apku04/stm32_saturn/.squad/log/2026-04-23T14:50:20Z-i2c2-ina219-beacon.md

# Session Log: I2C2 / INA219 Beacon Implementation

**Timestamp:** 2026-04-23T14:50:20Z  
**Session:** i2c2-ina219-beacon  
**Team Root:** /home/pi/work/stm32

---

## Executive Summary

Squad successfully resolved a critical I2C2/INA219 pin mismatch and restored LED functionality 
through coordinated PCB verification, code review, and surgical correction.

### Timeline
- **2025-07-14:** Kotov identified PCB truth (PB8/9, AF6, addr 0x40)
- **2025-07-17:** Yarrick implemented I2C2+INA219 (wrong pins: PB13/14)
- **2025-07-17:** Eisenhorn reviewed & rejected (issued lock-out, prescribed fix)
- **2025-07-18:** Cawl applied fix (PB8/9 AF6, restored LEDs)
- **2026-04-23:** Brostin testing (in progress)

### Outcome
- **Firmware state:** Commit 910cb9c (clean build)
- **INA219:** Correct pins (PB8/9) + correct AF (6) + correct peripheral (I2C2)
- **LEDs:** Restored on PB13/PB14
- **Beacon:** V2 format (7 bytes: shunt/bus/bat/chg)
- **Monitor:** Parsing updated for V2 + legacy fallback

---

## Root Cause

**The bug was never about which I2C peripheral (I2C2 is correct).**  
**The bug was not even about pins (PB8/PB9 is correct).**  

**The bug was: using AF4 instead of AF6**

On STM32U073CBT6, PB8/PB9 can be routed to either:
- AF4 → I2C1 peripheral (original code, wrong)
- AF6 → I2C2 peripheral (correct, 1-line fix)

Previous "fixes" (moving to PB6/7, then PB13/14) were chasing symptoms instead of 
addressing the root cause. Eisenhorn's independent PCB verification prevented a 
third wrong migration.

---

## Agent Contributions

### Kotov (PCB Expert)
- Decoded EasyEDA SQLite DB (stm32_lora.eprj)
- Traced physical net topology: INA219 on PB8/9 (not PB6/7 or PB13/14)
- Verified AF mapping: PB8/9 support AF4→I2C1 or AF6→I2C2
- **Status:** Correct on all technical points

### Yarrick (STM32 Firmware)
- Implemented I2C2 driver with base-address macros (scalable design)
- Added `ina219_read_shunt_mv()` for full current measurement
- Extended beacon to 7 bytes (shunt/bus/bat/chg)
- Updated monitor with V2 beacon parsing
- **Issue:** Selected wrong pins (PB13/14 = LEDs, not INA219)
- **Lesson:** Always verify pin assignments against PCB schematic before committing
- **Status:** Locked out from I2C/pin changes; code quality otherwise sound

### Eisenhorn (Hallucination Detective)
- Independently verified PCB topology (coordinate tracing)
- Identified root cause: AF4 vs AF6 (not pins themselves)
- Performed register/protocol audit (all correct in Yarrick's code)
- Issued REJECTED verdict with lock-out and prescribed fix
- **Status:** Prevented third wrong pin migration

### Cawl (Architect)
- Executed 3 surgical edits (hw_pins.h, i2c.c, main.c)
- Restored PB8/PB9 (AF6) for I2C2/INA219
- Restored LED functionality (PB13/PB14)
- Clean build, no regressions
- **Commit:** 910cb9c
- **Status:** Fix applied; testing in progress

### Brostin (Integration Specialist)
- Wrote comprehensive test plan (ina219_beacon_test_plan.md)
- Running single + target-to-target tests
- **Status:** In progress
- Previous findings: I2C1/I2C2 mismatch, lack of shunt register, no bus recovery

---

## Technical Details

### Pin Assignment
| Component | Pins | AF | Peripheral | Status |
|---|---|----|---  |---|
| INA219 | PB8/9  | 6  | I2C2 | ✅ Correct |
| I2C conn  | PB6/7  | 4  | I2C1 | ✅ External header |
| LEDs | PB13/14| —  | GPIO | ✅ Restored |

### Firmware Files Modified (Cawl's fix)
1. `firmware/src/board/hw_pins.h` — Pin defines & comments
2. `firmware/src/driver/i2c.c` — AF6 setting in i2c2_init()
3. `firmware/app/lora/main.c` — LED function restoration

### Beacon Payload (V2)
```
[0:1]   shunt_mv (int16, big-endian)  — INA219 reg 0x01
[2:3]   bus_mv (uint16, big-endian)   — INA219 reg 0x02 >> 3
[4:5]   bat_mv (uint16, LE)           — ADC result × 6600/4096
[6]     chg (uint8)                   — charge status
```

### Monitor Parser
- BEACON_PATTERN_V2: `[BEACON] shunt=... bus=... bat=... chg=... entries=...`
- Legacy fallback: `[BEACON] bat=... sol=... chg=...` (5-byte format)

---

## Decision Log

### Decision 1: INA219 PCB Ground Truth (Kotov)
- **Date:** 2025-07-14
- **Status:** Finding (requires firmware action)
- **Key facts:** PB8/9 (INA219), PB6/7 (I2C header), addr 0x40, AF6 for I2C2

### Decision 2: I2C2 Migration (Yarrick)
- **Date:** 2025-07-17
- **Status:** Implemented but **REJECTED**
- **Commit:** 1bba9d5
- **Issue:** Wrong pins (PB13/14 = LEDs, not wired to INA219)

### Decision 3: I2C Pin Conflict Verdict (Eisenhorn)
- **Date:** 2025-07-17
- **Status:** REJECTED Yarrick, issued lock-out
- **Prescribed fix:** PB8/9 (AF6), restore LEDs
- **Key lesson:** AF4 vs AF6 was the 1-line fix all along

### Decision 4: I2C2 Pin Correction (Cawl)
- **Date:** 2025-07-18
- **Status:** Applied (commit 910cb9c)
- **Scope:** 3 surgical edits, build clean

---

## Cross-Agent Learnings

### For Yarrick
- Always verify pin assignments against Kotov's PCB database before committing
- Prefer AF changes (1-line fix) over pin migrations (PCB verification required)
- **Lock-out:** I2C and pin changes; others own I2C/INA219 domain until further notice

### For Ravenor
- INA219 now on I2C2 (not I2C1)
- Beacon format is now 7 bytes (V2), legacy 5-byte format still supported
- PCB has two I2C buses: I2C1 on PB6/7 (external), I2C2 on PB8/9 (INA219)
- **Shared knowledge:** Kotov's PCB topology findings (pin mapping, AF values)

### For Future Squad
1. **PCB verification before pin changes:** Always consult Kotov's EasyEDA database
2. **AF vs pins:** AF changes (register-only) are cheaper than pin migrations (requires PCB verification)
3. **Lock-outs protect domain:** When an agent breaks a subsystem, lock-out prevents repeat errors
4. **Code quality ≠ correctness:** Yarrick's code was well-structured but used wrong pins — PCB verification is orthogonal to code review

---

## Testing Status

**Pending:** Brostin's test results (single + target-to-target)

**Test plan:** `firmware/app/lora/test/ina219_beacon_test_plan.md`

### Known Constraints (Brostin's baseline findings)
- No I2C bus recovery (stuck SDA/SCL requires power cycle)
- INA219 failure returns 0 (no crash), should add debug `get ina219` command
- Beacon timeout: ~6ms (100k iterations)

---

## Files Staged for Commit

```
.squad/orchestration-log/
  2026-04-23T14:50:20Z-kotov-i2c2-pins.md
  2026-04-23T14:50:20Z-yarrick-i2c2-ina219.md
  2026-04-23T14:50:20Z-eisenhorn-review-i2c2.md
  2026-04-23T14:50:20Z-cawl-pin-fix.md
  2026-04-23T14:50:20Z-brostin-run-tests.md

.squad/log/
  2026-04-23T14:50:20Z-i2c2-ina219-beacon.md (this file)

.squad/decisions.md
  (merged from inbox, deduplicated)
```
