apku04/stm32_saturn/.squad/orchestration-log/2026-04-23T14:50:20Z-yarrick-i2c2-ina219.md

# Orchestration Log: yarrick-i2c2-ina219

**Timestamp:** 2026-04-23T14:50:20Z  
**Agent:** Yarrick (STM32 firmware)  
**Task:** Fix INA219 on I2C2, add INA219 + battery voltage to beacon payload

## Summary

Yarrick implemented I2C2 driver + INA219 reads + beacon v2 payload:
- Refactored `i2c.c` with base-address macros to support I2C1/I2C2
- Added `i2c2_init()` on pins PB13/PB14 (AF6, I2C2 peripheral)
- Implemented `ina219_read_shunt_mv()` (register 0x01, signed 16-bit)
- Extended beacon payload from 5 bytes (bat/sol/chg) to 7 bytes (shunt/bus/bat/chg)
- Updated `lora_monitor.py` to parse new V2 beacon format

## Commit

- **Hash:** 1bba9d5
- **Status:** REJECTED by Eisenhorn (wrong pins)
- **Reason:** INA219 physically on PB8/PB9, not PB13/PB14 (LED pins)

## Issue

Yarrick did not verify pin assignments against the PCB schematic before reassigning pins. 
PB13/PB14 are the LED pins, not connected to INA219. This broke LED functionality and 
still left INA219 unresponsive.

## Lock-out

**Yarrick is locked out from further I2C/pin changes** by Eisenhorn until corrections 
are made by a different agent (Cawl or Kotov).

## Code Quality Note

Despite the wrong pins, Yarrick's code was well-structured:
- I2C2 base address (0x40005800) correct
- RCC clock bit (22) correct
- TIMINGR value correct for 100kHz @ 16MHz HSI
- INA219 register reads and beacon payload format correct
- Monitor parsing logic correct

## Files Generated

- `firmware/src/board/hw_pins.h` — I2C2_SCL/SDA on PB13/PB14 (INCORRECT, later reverted)
- `firmware/src/driver/i2c.h` — Added i2c2_* declarations
- `firmware/src/driver/i2c.c` — Refactored with base-address macros
- `firmware/src/driver/ina219.h` — Added ina219_read_shunt_mv()
- `firmware/src/driver/ina219.c` — Switched to i2c2_*() calls
- `firmware/app/lora/main.c` — V2 beacon payload (7 bytes), disabled LED functions
- `tools/lora_monitor.py` — Added BEACON_PATTERN_V2 regex

## Decision Recorded

- `.squad/decisions/inbox/yarrick-i2c2-ina219.md` — decision summary + file manifest
