apku04/stm32_saturn/docs/hardware/SCH_Schematic1_1-P1_2026-04-24.png

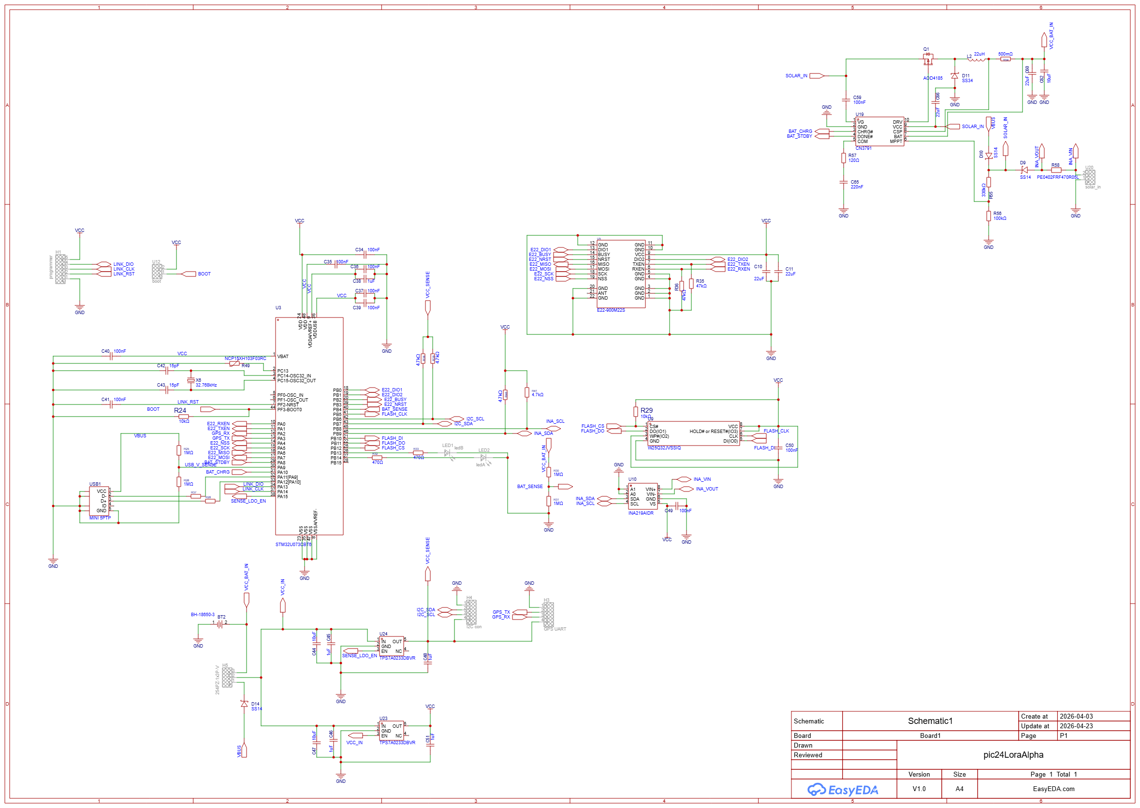
docs/hardware/SCH_Schematic1_1-P1_2026-04-24.png
