apku04/stm32_saturn/.squad/orchestration-log/2026-04-23T14:50:20Z-cawl-pin-fix.md

# Orchestration Log: cawl-pin-fix

**Timestamp:** 2026-04-23T14:50:20Z  
**Agent:** Cawl (Architect)  
**Task:** Apply surgical fix to correct I2C2 pins and restore LED functionality

## Summary

Cawl executed Eisenhorn's prescribed fix with three surgical edits:

### Changes Applied

**1. `firmware/src/board/hw_pins.h`**
- Removed `I2C2_SCL/SDA` defines on PB13/PB14
- Restored `LED1_PIN=13` and `LED2_PIN=14`
- Updated comment: "I2C2 (INA219 on PB8/PB9, AF6)"

**2. `firmware/src/driver/i2c.c`**
- Modified `i2c2_init()` to use `INA_SCL_PIN` (8) and `INA_SDA_PIN` (9)
- Set AF to 6 (not 4) in AFRH register: `afrh = 0x66` (AF6 for PB8 and PB9)
- Kept I2C2 peripheral registers and RCC bit 22 unchanged

**3. `firmware/app/lora/main.c`**
- Restored `led_init()`, `led1_toggle()`, `led2_toggle()`, `led1_on()` functions
- Restored LED GPIO configuration (PB13/PB14 as output, push-pull)
- Kept beacon payload v2 format and INA219 calls intact

### Constraints Preserved
- Beacon payload format unchanged (7 bytes: shunt/bus/bat/chg)
- I2C2 TIMINGR unchanged (0x30420F13)
- No other files modified

## Commit

- **Hash:** 910cb9c
- **Build Status:** Clean (no errors)
- **Test Status:** Pending Brostin

## Impact

- INA219 now correctly routed to I2C2 on PB8/PB9 (AF6)
- LED functionality fully restored
- Beacon v2 payload (7 bytes) ready for testing
- Firmware aligned with PCB schematic

## Files Generated

- `.squad/decisions/inbox/cawl-pin-fix.md` — decision record for this fix
