apku04/stm32_saturn/.squad/agents/ralph/history.md

# Project Context

- **Project:** stm32
- **Created:** 2026-04-23

## Core Context

Agent Ralph initialized and ready for work.

## Recent Updates

📌 Team initialized on 2026-04-23

## Learnings

Initial setup complete.
