apku04/stm32_saturn/SCH_Schematic1_2026-04-22.pdf

# GND VBUS

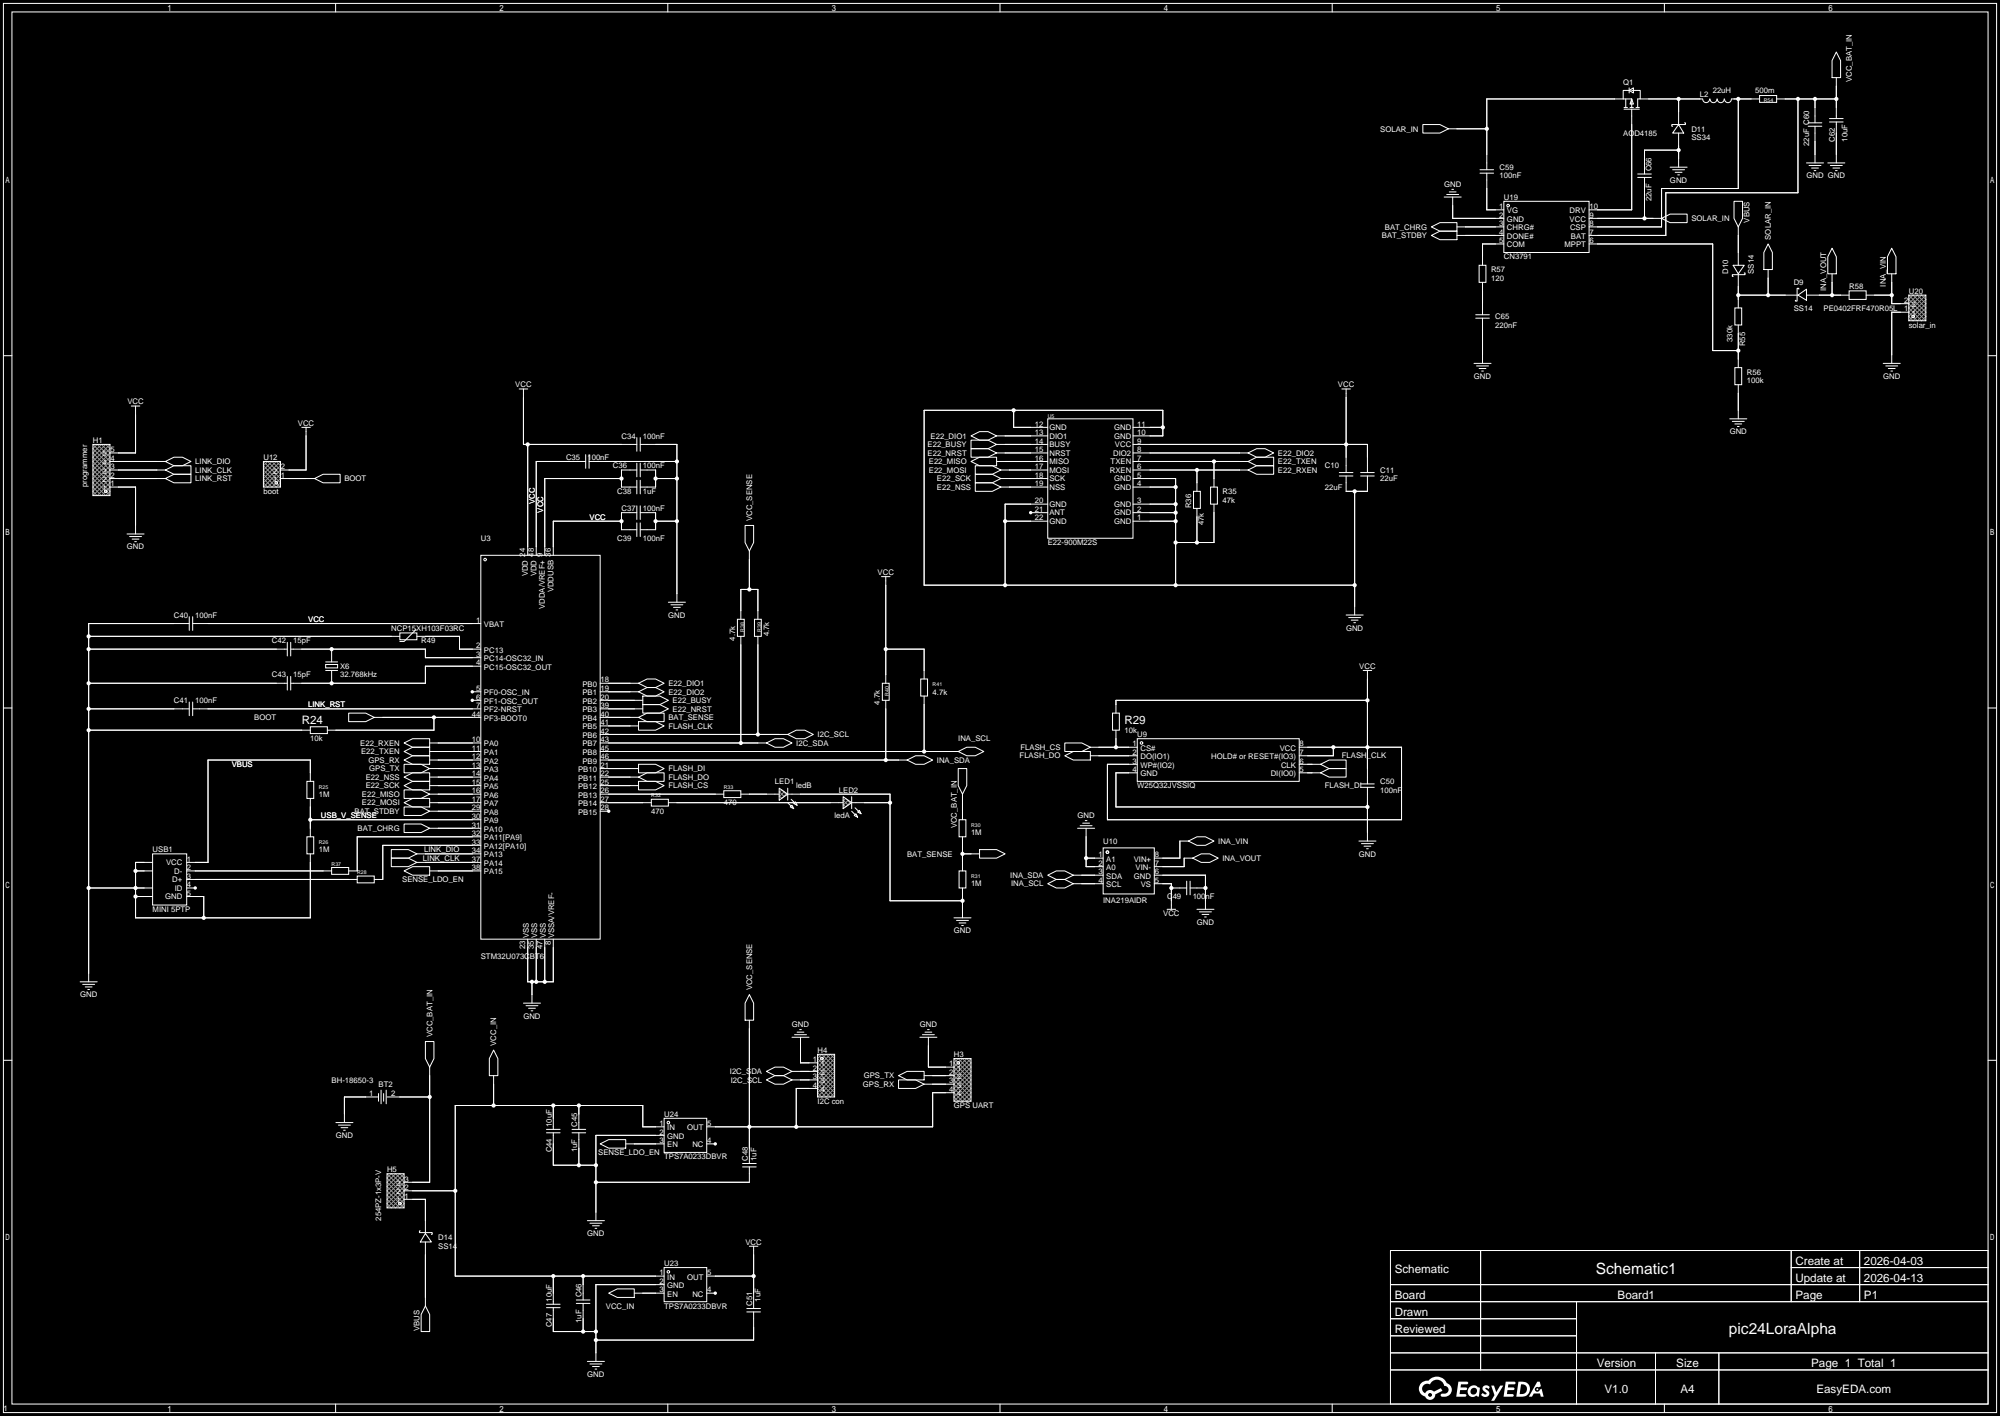
[picture p2: page 1]

Schematic | Schematic1 | Create at | 2026-04-03

Update at | 2026-04-13

Board | Board1 | Page | P1
Drawn | | pic24LoraAlpha
Reviewed

Version | Size | Page 1 Total 1
V1.0 | A4 | EasyEDA.com
