apku04/stm32_saturn/(list of files, drawings)

Other design files:
stm32_lora.eprj
