apku04/stm32_saturn/firmware/src/system/terminal.c

/*
 * terminal.c — USB command parser and menu interface
 * Ported from PIC24 — replaced sprintf with snprintf, removed PIC24-specifics
 */

#include <stdio.h>
#include <string.h>
#include <stdint.h>
#include <stdlib.h>
#include "terminal.h"
#include "stm32u0.h"
#include "radio.h"
#include "timer.h"
#include "hal.h"
#include "maclayer.h"
#include "networklayer.h"
#include "flash_config.h"
#include "packetBuffer.h"
#include "adc.h"
#include "ina219.h"
#include "i2c.h"
#include "bb_i2c.h"
#include "bme280.h"
#include "sht3x.h"
#include "flash_ota.h"
#include "ota_apply.h"
#include "gps.h"
#include "ext_flash.h"
#include "event_log.h"
#include "version.h"

uint8_t sniffer = 0;

/* Command line buffer. Must hold the longest command — an OTA DATA relay
 * "send ota data <t> <off> <hex>" with a 192-byte chunk is ~408 chars of hex
 * plus the prefix. 480 leaves margin. (argv[] is oversized to match, which is
 * harmless — far more slots than any command has tokens.) */
#define MAX_ARGV 480

static uint16_t parseArgs(uint8_t *str, uint8_t *argv[]);
static void help_command(void);
static void get_commands(uint16_t argc, uint8_t *argv[]);
static void send_commands(uint16_t argc, uint8_t *argv[]);
static uint8_t set_commands(uint16_t argc, uint8_t *argv[]);
static void ping_commands(void);
static void menu(uint16_t argc, uint8_t *argv[]);
static void set_frequency(uint32_t freq);
static void set_data_rate(uint8_t data_rate);
static void set_tx_power(uint8_t power);
static void set_macAddr(uint8_t mac_addr);
static void softwareReset(void);
static void jump_to_bootloader(void);

static deviceData_t flash_data;
static ulme Ulme;

static uint8_t beacon_flag_val = 1;
void send_beacon_flag(uint8_t flag) { beacon_flag_val = flag; }
uint8_t get_beacon_flag(void) { return beacon_flag_val; }

void terminal(uint8_t *msg, uint16_t size) {
    uint8_t cmdStr[MAX_ARGV];
    uint8_t *argv[MAX_ARGV];
    uint16_t argc;

    if (size >= MAX_ARGV) size = MAX_ARGV - 1;
    memcpy(cmdStr, msg, size);
    cmdStr[size] = '\0';
    argc = parseArgs(cmdStr, argv);
    menu(argc, argv);
}

void user_layer_init(PacketBuffer *pTxBuf) {
    Ulme.pktTxBuf = pTxBuf;
}

static uint16_t parseArgs(uint8_t *str, uint8_t *argv[]) {
    uint16_t argc = 0;
    uint8_t *ch = str;

    if (*ch == '\r' || *ch == '\n' || *ch == '\0') return 0;
    while (*ch == ' ') ch++;

    argv[argc++] = ch;
    while (*ch != ' ' && *ch != '\0' && *ch != '\r' && *ch != '\n') ch++;
    if (*ch == ' ' || *ch == '\r' || *ch == '\n') {
        *ch++ = '\0';
        while (*ch == ' ') ch++;
    }

    while (*ch != '\0' && *ch != '\r' && *ch != '\n') {
        argv[argc++] = ch;
        while (*ch != ' ' && *ch != '\0' && *ch != '\r' && *ch != '\n') ch++;
        if (*ch == ' ' || *ch == '\r' || *ch == '\n') {
            *ch++ = '\0';
            while (*ch == ' ' && *ch != '\0') ch++;
        }
    }
    return argc;
}

static void menu(uint16_t argc, uint8_t *argv[]) {
    char s[200];

    if (!argc) return;

    const char *cmd = (const char *)argv[0];

    if (strcmp(cmd, "help") == 0) {
        help_command();
    } else if (strcmp(cmd, "get") == 0) {
        get_commands(argc, argv);
    } else if (strcmp(cmd, "set") == 0) {
        set_commands(argc, argv);
    } else if (strcmp(cmd, "send") == 0) {
        send_commands(argc, argv);
    } else if (strcmp(cmd, "reset") == 0) {
        softwareReset();
    } else if (strcmp(cmd, "clear") == 0 && argc >= 2 &&
               strcmp((const char *)argv[1], "log") == 0) {
        /* `clear log` — wipe the persistent boot/reset event log. */
        event_log_clear();
        print("event log cleared\n");
    } else if (strcmp(cmd, "dfu") == 0) {
        jump_to_bootloader();
    } else if (strcmp(cmd, "version") == 0) {
        snprintf(s, sizeof(s), "STM32_LORA_V1 %s (built %s)\n",
                 fw_version_string(), fw_build_id_string());
        print(s);
    } else if (strcmp(cmd, "ping") == 0) {
        ping_commands();
    } else {
        snprintf(s, sizeof(s), "Error: unknown cmd: %s\n", argv[0]);
        print(s);
        print("Type <help> for available commands\n");
    }
}

static void help_command(void) {
    print("Commands:\n"
          "  help - This message\n"
          "  get <param>\n"
          "  set <param> <value>\n"
          "  send <message>\n"
          "  send cfg pwr <N>          remote: set tx_power (1..22)\n"
          "  send cfg sf  <N>          remote: set SF (5..12)\n"
          "  send cfg both <pwr> <sf>  remote: set both\n"
          "  send cfgota prepare|data|end ...  remote: OTA-configuration (ack'd, rollback-safe)\n"
          "  ping\n"
          "  version\n"
          "  reset\n"
          "  dfu - Enter USB DFU bootloader\n"
          "Params: frequency, data_rate, tx_power, mac_address, flash, routing, battery, solar, charge\n");
}

static uint8_t set_commands(uint16_t argc, uint8_t *argv[]) {
    char s[200];

    if (argc >= 2 && strcmp((const char *)argv[1], "flash") == 0) {
        writeFlash(&flash_data);
        print("Done\n");
        return 0;
    }

    /* --- BOR (Brown-Out Reset) one-time option byte programming ---
     * Usage: set bor <0..3>
     *   0 = BOR Level 1 (~1.7 V)  -- effectively off
     *   1 = BOR Level 2 (~2.0 V)
     *   2 = BOR Level 3 (~2.5 V)  -- recommended for solar+Li-ion node
     *   3 = BOR Level 4 (~2.7 V)
     * After programming, OBL_LAUNCH triggers a reset and the new
     * threshold is enforced on every subsequent power cycle.
     * This is permanent (survives flash erase/reprogram).
     */
    if (argc >= 3 && strcmp((const char *)argv[1], "bor") == 0) {
        uint8_t lev = (uint8_t)atoi((const char *)argv[2]);
        if (lev > 3) { print("Error: bor must be 0..3\n"); return 1; }

        /* Wait for any flash op to settle */
        while (FLASH_SR & FLASH_SR_BSY);

        /* Unlock flash control */
        if (FLASH_CR & FLASH_CR_LOCK) {
            FLASH_KEYR = FLASH_KEY1;
            FLASH_KEYR = FLASH_KEY2;
        }
        /* Unlock option bytes */
        FLASH_OPTKEYR = FLASH_OPTKEY1;
        FLASH_OPTKEYR = FLASH_OPTKEY2;

        if (FLASH_CR & FLASH_CR_OPTLOCK) {
            print("Error: option bytes still locked\n");
            FLASH_CR |= FLASH_CR_LOCK;
            return 1;
        }

        /* Read-modify-write OPTR: enable BOR + set level */
        uint32_t optr = FLASH_OPTR;
        optr |=  FLASH_OPTR_BOR_EN;
        optr &= ~FLASH_OPTR_BOR_LEV_MSK;
        optr |=  ((uint32_t)lev << FLASH_OPTR_BOR_LEV_POS) & FLASH_OPTR_BOR_LEV_MSK;
        FLASH_OPTR = optr;

        /* Trigger option byte program */
        FLASH_CR |= FLASH_CR_OPTSTRT;
        while (FLASH_SR & FLASH_SR_BSY);

        snprintf(s, sizeof(s),
                 "BOR programmed: level=%u OPTR=0x%08lX\n"
                 "Triggering OBL_LAUNCH (board will reset)...\n",
                 lev, (unsigned long)FLASH_OPTR);
        print(s);

        /* OBL_LAUNCH: reload option bytes from flash → MCU resets */
        FLASH_CR |= FLASH_CR_OBL_LAUNCH;
        /* Should never reach here */
        while (1);
    }

    /* --- OTA commands --- */
    if (argc >= 2 && strcmp((const char *)argv[1], "ota") == 0) {
        if (argc >= 3 && strcmp((const char *)argv[2], "erase") == 0) {
            ota_err_t rc = ota_erase();
            print(rc == OTA_OK ? "OTA Erase: OK\r\n" : "OTA Erase: FAIL\r\n");
            return 0;
        }
        if (argc >= 5 && strcmp((const char *)argv[2], "write") == 0) {
            uint32_t offset = strtoul((const char *)argv[3], NULL, 16);
            const char *hex = (const char *)argv[4];
            if (strlen(hex) != 16) {
                print("OTA Write: FAIL err=-2\r\n");
                return 1;
            }
            uint8_t data[8];
            for (int i = 0; i < 8; i++) {
                char tmp[3] = { hex[i*2], hex[i*2+1], '\0' };
                data[i] = (uint8_t)strtoul(tmp, NULL, 16);
            }
            ota_err_t rc = ota_write(offset, data, 8);
            if (rc == OTA_OK) {
                print("OTA Write: OK\r\n");
            } else {
                char s[64];
                snprintf(s, sizeof(s), "OTA Write: FAIL err=%d\r\n", (int)rc);
                print(s);
            }
            return 0;
        }
        if (argc >= 4 && strcmp((const char *)argv[2], "pending") == 0) {
            uint16_t sz = (uint16_t)strtoul((const char *)argv[3], NULL, 10);
            ota_set_pending(sz);
            print("OTA Pending: SET\r\n");
            return 0;
        }
        if (argc >= 3 && strcmp((const char *)argv[2], "clear") == 0) {
            ota_clear_pending();
            print("OTA Pending: CLEARED\r\n");
            return 0;
        }
        print("Unknown OTA set command\n");
        return 1;
    }

    if (argc >= 3) {
        if (strcmp((const char *)argv[1], "frequency") == 0) {
            uint32_t freq = strtol((const char *)argv[2], NULL, 10);
            if (freq == 444000000 || freq == 868000000 || freq == 870000000) {
                set_frequency(freq);
                flash_data.radioFreq1 = (freq >> 24) & 0xFF;
                flash_data.radioFreq2 = (freq >> 16) & 0xFF;
                flash_data.radioFreq3 = (freq >> 8) & 0xFF;
                flash_data.radioFreq4 = freq & 0xFF;
            } else {
                snprintf(s, sizeof(s), "Error: frequency must be 444000000, 868000000 or 870000000\n");
                print(s);
                return 1;
            }
        } else if (strcmp((const char *)argv[1], "data_rate") == 0) {
            uint8_t dr = strtol((const char *)argv[2], NULL, 10);
            if (dr >= 5 && dr <= 12) {
                set_data_rate(dr);
                flash_data.radioDataRate = dr;
            } else {
                print("Error: data_rate must be 5-12\n");
                return 1;
            }
        } else if (strcmp((const char *)argv[1], "tx_power") == 0) {
            uint8_t pw = strtol((const char *)argv[2], NULL, 10);
            if (pw >= 1 && pw <= 22) {
                set_tx_power(pw);
                flash_data.radioTxPwr = pw;
            } else {
                print("Error: tx_power must be 1-22\n");
                return 1;
            }
        } else if (strcmp((const char *)argv[1], "mac_address") == 0) {
            uint8_t addr = strtol((const char *)argv[2], NULL, 10);
            set_macAddr(addr);
            flash_data.deviceID = addr;
        } else if (strcmp((const char *)argv[1], "beacon") == 0) {
            uint8_t b = strtol((const char *)argv[2], NULL, 10);
            if (b == 0 || b == 1) send_beacon_flag(b);
            print("Done\n");
        } else if (strcmp((const char *)argv[1], "beacon_interval") == 0) {
            uint16_t sec = (uint16_t)strtoul((const char *)argv[2], NULL, 10);
            if (!timer_set_beacon_interval_s(sec)) {
                print("Error: beacon_interval must be 1-255 seconds\n");
                return 1;
            }
            flash_data.paramN = (uint8_t)sec;
            if (argc >= 4 && strcmp((const char *)argv[3], "persist") == 0)
                writeFlashParamByte(PARAMETER_N, (uint8_t)sec);
            print("Done\n");
        } else {
            print("Unknown parameter\n");
        }
    } else {
        print("Insufficient arguments\n");
    }
    return 0;
}

static void get_commands(uint16_t argc, uint8_t *argv[]) {
    char buf[128];

    if (argc <= 1) return;

    if (strcmp((const char *)argv[1], "frequency") == 0) {
        uint32_t freq = radio_get_channel();
        snprintf(buf, sizeof(buf), "Frequency: %lu Hz\n", (unsigned long)freq);
        print(buf);
    } else if (strcmp((const char *)argv[1], "data_rate") == 0) {
        snprintf(buf, sizeof(buf), "Data Rate: %u\n", radio_get_datarate());
        print(buf);
    } else if (strcmp((const char *)argv[1], "tx_power") == 0) {
        snprintf(buf, sizeof(buf), "TX Power: %u\n", radio_get_tx_power());
        print(buf);
    } else if (strcmp((const char *)argv[1], "mac_address") == 0) {
        snprintf(buf, sizeof(buf), "MAC Address: %u\n", get_mac_address());
        print(buf);
    } else if (strcmp((const char *)argv[1], "beacon_interval") == 0) {
        snprintf(buf, sizeof(buf), "Beacon Interval: %u s\n", timer_get_beacon_interval_s());
        print(buf);
    } else if (strcmp((const char *)argv[1], "uid") == 0) {
        const volatile uint8_t *p = (const volatile uint8_t *)UID_BASE;
        snprintf(buf, sizeof(buf),
                 "UID: %02X%02X%02X%02X %02X%02X%02X%02X %02X%02X%02X%02X\n",
                 p[0],p[1],p[2],p[3], p[4],p[5],p[6],p[7], p[8],p[9],p[10],p[11]);
        print(buf);

    } else if (strcmp((const char *)argv[1], "bor") == 0) {
        uint32_t optr = FLASH_OPTR;
        uint8_t en  = (optr & FLASH_OPTR_BOR_EN) ? 1 : 0;
        uint8_t lev = (uint8_t)((optr & FLASH_OPTR_BOR_LEV_MSK) >> FLASH_OPTR_BOR_LEV_POS);
        const char *t[4] = { "~1.7V (off)", "~2.0V", "~2.5V", "~2.7V" };
        snprintf(buf, sizeof(buf),
                 "BOR: en=%u level=%u (%s) OPTR=0x%08lX\n",
                 en, lev, t[lev], (unsigned long)optr);
        print(buf);
    } else if (strcmp((const char *)argv[1], "flash") == 0) {
        deviceData_t fData;
        uint8_t *p = (uint8_t *)&fData;
        const uint8_t ids[] = { DEVICE_ID, RADIO_FREQ1, RADIO_FREQ2, RADIO_FREQ3,
                                RADIO_FREQ4, RADIO_DR, RADIO_TX_PWR };
        for (int i = 0; i < (int)(sizeof(ids)/sizeof(ids[0])); i++)
            readFlash(ids[i], p + i);

        uint32_t freq = ((uint32_t)fData.radioFreq1 << 24) |
                        ((uint32_t)fData.radioFreq2 << 16) |
                        ((uint32_t)fData.radioFreq3 << 8) |
                        (uint32_t)fData.radioFreq4;
        snprintf(buf, sizeof(buf),
                 "\nFlash Data\nFrequency: %lu Hz\nData Rate: %u\n"
                 "TX Power: %u\nMAC Address: %u\n",
                 (unsigned long)freq, fData.radioDataRate,
                 fData.radioTxPwr, fData.deviceID);
        print(buf);
    } else if (strcmp((const char *)argv[1], "routing") == 0) {
        print_routing_table();
    } else if (strcmp((const char *)argv[1], "gps") == 0) {
        if (argc >= 3 && strcmp((const char *)argv[2], "reinit") == 0) {
            gps_init();
            print("GPS reinitialised\n");
            return;
        }
        if (argc >= 3 && strcmp((const char *)argv[2], "raw") == 0) {
            uint8_t on = (argc >= 4) ? (uint8_t)atoi((const char *)argv[3]) : 1;
            gps_set_raw_echo(on);
            snprintf(buf, sizeof(buf), "GPS raw echo: %u\n", on);
            print(buf);
            return;
        }
        if (argc >= 3 && strcmp((const char *)argv[2], "baud") == 0 && argc >= 4) {
            uint32_t b = strtoul((const char *)argv[3], NULL, 10);
            gps_set_baud(b);
            snprintf(buf, sizeof(buf), "GPS baud: %lu\n", (unsigned long)b);
            print(buf);
            return;
        }
        if (argc >= 3 && strcmp((const char *)argv[2], "af") == 0 && argc >= 4) {
            uint8_t a = (uint8_t)atoi((const char *)argv[3]);
            gps_set_af(a);
            snprintf(buf, sizeof(buf), "GPS AF: %u\n", a);
            print(buf);
            return;
        }
        if (argc >= 3 && strcmp((const char *)argv[2], "probe") == 0) {
            uint32_t r = gps_probe_pa3();
            uint32_t trans = r & 0xFFFFu;
            uint32_t lows  = r >> 16;
            snprintf(buf, sizeof(buf),
                     "PA3 probe (~1s): transitions=%lu  low_samples=%lu (clamp 65535)\n",
                     (unsigned long)trans, (unsigned long)lows);
            print(buf);
            return;
        }
        const gps_fix_t *f = gps_get_fix();
        char nbuf[110];
        gps_get_last_nmea(nbuf, sizeof(nbuf));
        uint32_t toggles = 0;
        uint32_t isr = gps_diag(&toggles);
        snprintf(buf, sizeof(buf),
                 "GPS sentences=%lu fix=%u sats=%u "
                 "lat=%ld.%06ld lon=%ld.%06ld alt=%dm time=%06lu\n",
                 (unsigned long)f->sentences, f->fix_quality, f->sats,
                 (long)(f->lat_udeg / 1000000), (long)(f->lat_udeg < 0 ? -f->lat_udeg : f->lat_udeg) % 1000000,
                 (long)(f->lon_udeg / 1000000), (long)(f->lon_udeg < 0 ? -f->lon_udeg : f->lon_udeg) % 1000000,
                 f->alt_m, (unsigned long)f->time_hms);
        print(buf);
        snprintf(buf, sizeof(buf),
                 "GPS diag: USART2_ISR=0x%08lX PA2_lvl=%u PA3_lvl=%u (1.5s)\n",
                 (unsigned long)isr,
                 (unsigned)((toggles >> 0) & 1u),
                 (unsigned)((toggles >> 1) & 1u));
        print(buf);
        snprintf(buf, sizeof(buf),
                 "GPS pin: PA2 mod=%u af=%u pu=%u  PA3 mod=%u af=%u pu=%u\n",
                 (unsigned)((toggles >> 4)  & 3u),
                 (unsigned)((toggles >> 8)  & 0xFu),
                 (unsigned)((toggles >> 16) & 3u),
                 (unsigned)((toggles >> 6)  & 3u),
                 (unsigned)((toggles >> 12) & 0xFu),
                 (unsigned)((toggles >> 18) & 3u));
        print(buf);
        if (nbuf[0]) {
            snprintf(buf, sizeof(buf), "GPS last NMEA: %s\n", nbuf);
            print(buf);
        }
        uint32_t ic, rn, fe2;
        gps_isr_stats(&ic, &rn, &fe2);
        snprintf(buf, sizeof(buf),
                 "GPS ISR: calls=%lu rxne=%lu fe=%lu CR1=0x%08lX BRR=%lu NVIC=0x%08lX\n",
                 (unsigned long)ic, (unsigned long)rn, (unsigned long)fe2,
                 (unsigned long)gps_get_cr1(), (unsigned long)gps_get_brr(),
                 (unsigned long)gps_get_nvic());
        print(buf);
    } else if (strcmp((const char *)argv[1], "battery") == 0) {
        uint16_t raw = adc_read_battery_raw();
        uint32_t mv = ((uint32_t)raw * 6600UL) / 4096UL;
        snprintf(buf, sizeof(buf), "Battery: %lu mV (raw: %u)\n", (unsigned long)mv, raw);
        print(buf);
    } else if (strcmp((const char *)argv[1], "solar") == 0) {
        /* Full solar/charger readout from U10 INA219.
         * Shunt R = 0.05 Ω (R58, 50mΩ ±1%) → I[mA] = V_shunt[µV] / 50 */
        uint16_t bus_mv  = ina219_read_bus_mv();
        int32_t  sh_uv   = ina219_read_shunt_uv();
        int32_t  i_ma    = sh_uv / 50;
        int32_t  p_mw    = ((int32_t)bus_mv * i_ma) / 1000;
        ChargeStatus cs  = charge_get_status();
        snprintf(buf, sizeof(buf),
                 "Solar:  bus=%u mV  shunt=%ld µV  I=%ld mA  P=%ld mW  charge=%s\n",
                 bus_mv, (long)sh_uv, (long)i_ma, (long)p_mw, charge_status_str(cs));
        print(buf);
    } else if (strcmp((const char *)argv[1], "charge") == 0) {
        ChargeStatus s = charge_get_status();
        snprintf(buf, sizeof(buf), "Charge: %s\n", charge_status_str(s));
        print(buf);
    } else if (strcmp((const char *)argv[1], "vrefint") == 0) {
        /* Read 4 samples; report each + average to expose any glitch */
        uint16_t s[4];
        uint32_t sum = 0;
        for (int i = 0; i < 4; i++) { s[i] = adc_read_vrefint_raw(); sum += s[i]; }
        uint16_t avg = (uint16_t)(sum / 4);
        uint16_t vdda = adc_vdda_from_raw(avg);
        uint16_t cal = *(volatile uint16_t *)0x1FFF6E68u;
        snprintf(buf, sizeof(buf),
                 "VREFINT raws: %u %u %u %u  avg=%u  CAL=%u  VDDA=%u mV\n",
                 s[0], s[1], s[2], s[3], avg, cal, vdda);
        print(buf);
    } else if (strcmp((const char *)argv[1], "ina") == 0) {
        /* Write config register and report I2C result */
        int wret = i2c2_write_reg(0x40, 0x00, 0x399F);
        snprintf(buf, sizeof(buf), "INA219 config write: %d\n", wret);
        print(buf);
        uint16_t raw_shunt = 0, raw_bus = 0;
        int sr = i2c2_read_reg(0x40, 0x01, &raw_shunt);
        int br = i2c2_read_reg(0x40, 0x02, &raw_bus);
        snprintf(buf, sizeof(buf),
                 "shunt reg: ret=%d raw=0x%04X (%d mV)\n"
                 "bus   reg: ret=%d raw=0x%04X (%u mV)\n",
                 sr, raw_shunt, (int16_t)raw_shunt / 100,
                 br, raw_bus, (raw_bus >> 3) * 4);
        print(buf);
    } else if (strcmp((const char *)argv[1], "i2cscan") == 0) {
        print("Scanning I2C2 (0x08-0x77)...\n");
        for (uint8_t a = 0x08; a <= 0x77; a++) {
            uint8_t dummy;
            if (i2c2_read(a, &dummy, 1) == 0) {
                snprintf(buf, sizeof(buf), "  Found: 0x%02X\n", a);
                print(buf);
            }
        }
        print("Done\n");
    } else if (strcmp((const char *)argv[1], "bbscan") == 0) {
        /* First report idle line levels — empty bbscan with both lines high
         * means slaves are dead/missing; SCL=0 means hardware fault that
         * software can't recover from. */
        uint8_t scl = 0, sda = 0;
        bb_i2c_probe_idle(&scl, &sda);
        snprintf(buf, sizeof(buf),
                 "bb_i2c idle: SCL=%u SDA=%u  (both should be 1)\n", scl, sda);
        print(buf);
        print("Scanning bit-bang I2C (PB6/PB7)...\n");
        for (uint8_t a = 0x08; a <= 0x77; a++) {
            uint8_t dummy;
            if (bb_i2c_read(a, &dummy, 1) == 0) {
                snprintf(buf, sizeof(buf), "  Found: 0x%02X\n", a);
                print(buf);
            }
        }
        print("Done\n");
    } else if (strcmp((const char *)argv[1], "bme") == 0) {
        /* Diagnostic: dump BME280 chip id, raw H bytes, calibration H regs,
         * and the compensated values from a fresh sample. */
        uint8_t id = 0xFF;
        for (uint8_t a = 0x76; a <= 0x77; a++) {
            if (bb_i2c_write_then_read(a, 0xD0, &id, 1) == 0) {
                snprintf(buf, sizeof(buf),
                         "BME @0x%02X chip_id=0x%02X (%s)\n",
                         a, id,
                         id == 0x60 ? "BME280" :
                         id == 0x58 ? "BMP280 (NO HUMIDITY)" :
                         id == 0x61 ? "BME680" : "unknown");
                print(buf);
            }
        }
        uint8_t h1 = 0, h27[7] = {0}, raw[8] = {0};
        bb_i2c_write_then_read(0x76, 0xA1, &h1, 1);
        bb_i2c_write_then_read(0x76, 0xE1, h27, 7);
        snprintf(buf, sizeof(buf),
                 "calib: H1=%u  E1..E7=%02X %02X %02X %02X %02X %02X %02X\n",
                 h1, h27[0], h27[1], h27[2], h27[3], h27[4], h27[5], h27[6]);
        print(buf);
        bme280_sample();
        bb_i2c_write_then_read(0x76, 0xF7, raw, 8);
        snprintf(buf, sizeof(buf),
                 "raw F7..FE: %02X %02X %02X %02X %02X %02X %02X %02X\n",
                 raw[0], raw[1], raw[2], raw[3],
                 raw[4], raw[5], raw[6], raw[7]);
        print(buf);
        snprintf(buf, sizeof(buf), "T=%d cdeg  H=%u cpct  present=%d\n",
                 bme280_get_temp_cdeg(), bme280_get_hum_cpct(),
                 bme280_present());
        print(buf);
    } else if (strcmp((const char *)argv[1], "sht") == 0) {
        snprintf(buf, sizeof(buf), "SHT3x present=%d\n", sht3x_present());
        print(buf);
        if (sht3x_present()) {
            int r = sht3x_sample();
            snprintf(buf, sizeof(buf),
                     "sample ret=%d  T=%d cdeg  H=%u cpct\n",
                     r, sht3x_get_temp_cdeg(), sht3x_get_hum_cpct());
            print(buf);
        }
    } else if (strcmp((const char *)argv[1], "adcscan") == 0) {
        print("ADC scan ch0-19:\n");
        for (uint8_t ch = 0; ch <= 19; ch++) {
            uint16_t raw = adc_read_channel_raw(ch);
            if (raw > 20) {
                uint32_t mv = ((uint32_t)raw * 3300UL) / 4096UL;
                snprintf(buf, sizeof(buf), "  CH%02u: raw=%4u  pin=%4lumV\n", ch, raw, (unsigned long)mv);
                print(buf);
            }
        }
        uint16_t bat = adc_read_battery_mv();
        uint16_t braw = adc_read_battery_raw();
        snprintf(buf, sizeof(buf), "bat_mv=%u (raw=%u)\n", bat, braw);
        print(buf);
    } else if (strcmp((const char *)argv[1], "ota") == 0) {
        if (argc >= 3 && strcmp((const char *)argv[2], "bank") == 0) {
            snprintf(buf, sizeof(buf), "OTA Bank: 0x%08lX size=%lu\r\n",
                     (unsigned long)ota_bank_addr(), (unsigned long)ota_bank_size());
            print(buf);
        } else if (argc >= 5 && strcmp((const char *)argv[2], "read") == 0) {
            uint32_t offset = strtoul((const char *)argv[3], NULL, 16);
            uint32_t len = strtoul((const char *)argv[4], NULL, 10);
            if (len > 16) len = 16;
            uint8_t tmp[16];
            ota_read(offset, tmp, len);
            print("OTA Read:");
            for (uint32_t i = 0; i < len; i++) {
                char hx[4];
                snprintf(hx, sizeof(hx), " %02X", tmp[i]);
                print(hx);
            }
            print("\r\n");
        } else if (argc >= 3 && strcmp((const char *)argv[2], "pending") == 0) {
            uint16_t img_sz = 0;
            if (ota_is_pending(&img_sz)) {
                snprintf(buf, sizeof(buf), "OTA Pending: YES size=%u\r\n", img_sz);
            } else {
                snprintf(buf, sizeof(buf), "OTA Pending: NO\r\n");
            }
            print(buf);
        } else if (argc >= 3 && strcmp((const char *)argv[2], "selftest") == 0) {
            /* Exercises the flash erase+program-from-flash+verify sequence used
             * by the OTA applier, on a scratch bank page (no risk to the app). */
            bool ok = ota_self_test();
            snprintf(buf, sizeof(buf), "OTA SelfTest: %s\r\n", ok ? "PASS" : "FAIL");
            print(buf);
        }
    } else if (strcmp((const char *)argv[1], "cfgota") == 0) {
        /* Debug/test introspection for the CFG-OTA rollback state — reads the
         * same flash slots cfg_ota_rx_dispatch()/Reset_Handler use in main.c.
         * (There's no RAM-state equivalent here: cfgota_state is local to
         * main.c the same way ota_state is — this mirrors 'get ota pending'
         * in only exposing what's durably staged in flash.) */
        uint8_t pending = 0, peer = 0, tries = 0;
        uint8_t bpwr = 0, bsf = 0, bbeacon = 0;
        readFlash(CFG_OTA_PENDING, &pending);
        readFlash(CFG_OTA_VERIFY_PEER, &peer);
        readFlash(CFG_OTA_VERIFY_TRIES, &tries);
        readFlash(CFG_OTA_BACKUP_TXPWR, &bpwr);
        readFlash(CFG_OTA_BACKUP_SF, &bsf);
        readFlash(CFG_OTA_BACKUP_BEACON, &bbeacon);
        if (pending == 1) {
            snprintf(buf, sizeof(buf),
                     "CFGOTA Pending: YES peer=%u tries=%u backup_pwr=%u backup_sf=%u backup_beacon=%u\r\n",
                     peer, tries, bpwr, bsf, bbeacon);
        } else {
            snprintf(buf, sizeof(buf), "CFGOTA Pending: NO\r\n");
        }
        print(buf);
    } else if (strcmp((const char *)argv[1], "extflash") == 0) {
        uint32_t id = ext_flash_read_id();
        snprintf(buf, sizeof(buf), "JEDEC ID: 0x%06lX (%s)\n",
                 (unsigned long)id,
                 id == 0xEF4016 ? "W25Q32" : "unknown");
        print(buf);

        /* Write/read test at the LAST sector — sector 0 is reserved for the
         * persistent boot event log, so we mustn't erase it here. The W25Q32
         * is 4 MB; last sector starts at (4 MB - 4 KB) = 0x3FF000. */
        uint32_t test_addr = EXT_FLASH_TOTAL_SIZE - EXT_FLASH_SECTOR_SIZE;
        ext_flash_erase_sector(test_addr);
        uint8_t wr[16] = {0xDE,0xAD,0xBE,0xEF, 0x01,0x02,0x03,0x04,
                          0xA5,0x5A,0x55,0xAA, 0x12,0x34,0x56,0x78};
        ext_flash_write(test_addr, wr, 16);
        uint8_t rd[16];
        ext_flash_read(test_addr, rd, 16);
        int pass = 1;
        for (int i = 0; i < 16; i++) {
            if (rd[i] != wr[i]) { pass = 0; break; }
        }
        snprintf(buf, sizeof(buf), "Write/Read test @0x%06lX: %s\n",
                 (unsigned long)test_addr, pass ? "PASS" : "FAIL");
        print(buf);
        print("Read: ");
        for (int i = 0; i < 16; i++) {
            char hx[4];
            snprintf(hx, sizeof(hx), "%02X ", rd[i]);
            print(hx);
        }
        print("\n");
    } else if (strcmp((const char *)argv[1], "log") == 0) {
        /* Dump the persistent boot/reset event log. One line per record;
         * fields match what the host already decodes from beacon v7 so the
         * same regex can parse this output offline. */
        snprintf(buf, sizeof(buf),
                 "event log: count=%lu head=%lu (cap=%u)\n",
                 (unsigned long)event_log_count(),
                 (unsigned long)event_log_head(),
                 EVENT_LOG_REC_COUNT);
        print(buf);
        for (uint32_t i = 0; i < EVENT_LOG_REC_COUNT; i++) {
            event_log_rec_t r;
            if (!event_log_read(i, &r))
                break;   /* slot empty → end of valid records */
            snprintf(buf, sizeof(buf),
                     "  [%lu] boot=%lu rst=0x%08lX last_stage=%u this_stage=%u "
                     "up_ms=%lu reached_main=%u hung_chk=%u\n",
                     (unsigned long)i,
                     (unsigned long)r.boot_count,
                     (unsigned long)r.rst_csr,
                     r.last_init_stage, r.this_init_stage,
                     (unsigned long)r.last_uptime_ms,
                     (r.flags & 0x0001) ? 1 : 0,
                     r.last_main_chk);
            print(buf);
        }
    } else if (strcmp((const char *)argv[1], "i2cread") == 0 && argc >= 4) {
        /* Usage: get i2cread <addr_hex> <reg_hex>
         * Reads a 16-bit big-endian register from an arbitrary I2C device.
         * Use to prove I2C read path with a known-good device on H4. */
        uint8_t addr = (uint8_t)strtoul((const char *)argv[2], NULL, 16);
        uint8_t reg  = (uint8_t)strtoul((const char *)argv[3], NULL, 16);
        uint16_t val = 0;
        int r = i2c2_read_reg(addr, reg, &val);
        snprintf(buf, sizeof(buf),
                 "i2c read  addr=0x%02X reg=0x%02X -> ret=%d val=0x%04X\n",
                 addr, reg, r, val);
        print(buf);
    }
}

static void send_commands(uint16_t argc, uint8_t *argv[]) {
    /* Range-test remote-config command:
     *   send cfg pwr <N>           -> tx_power = N (1..22)
     *   send cfg sf  <N>           -> data_rate (SF) = N (5..12)
     *   send cfg both <pwr> <sf>   -> both
     *   send cfg beacon <sec> [persist 0|1] [target|all]
     * Broadcasts across the mesh. Beacon config is target-filtered by the
     * receiver; target 255/all means every node applies and ACKs. */
    if (argc >= 3 && strcmp((const char *)argv[1], "cfg") == 0) {
        Packet pkt;
        memset(&pkt, 0, sizeof(Packet));
        pkt.pOwner = NET;
        pkt.pktDir = OUTGOING;
        pkt.control_app = CMD_CFG;

        const char *sub = (const char *)argv[2];
        if (argc >= 4 && strcmp(sub, "pwr") == 0) {
            uint8_t v = (uint8_t)strtol((const char *)argv[3], NULL, 10);
            if (v < 1 || v > 22) { print("Error: pwr must be 1..22\n"); return; }
            pkt.data[0] = 0x01;
            pkt.data[1] = v;
            pkt.length = 4 + 2;
        } else if (argc >= 4 && strcmp(sub, "sf") == 0) {
            uint8_t v = (uint8_t)strtol((const char *)argv[3], NULL, 10);
            if (v < 5 || v > 12) { print("Error: sf must be 5..12\n"); return; }
            pkt.data[0] = 0x02;
            pkt.data[1] = v;
            pkt.length = 4 + 2;
        } else if (argc >= 5 && strcmp(sub, "both") == 0) {
            uint8_t p = (uint8_t)strtol((const char *)argv[3], NULL, 10);
            uint8_t s = (uint8_t)strtol((const char *)argv[4], NULL, 10);
            if (p < 1 || p > 22 || s < 5 || s > 12) {
                print("Error: usage: send cfg both <pwr 1..22> <sf 5..12>\n");
                return;
            }
            pkt.data[0] = 0x03;
            pkt.data[1] = p;
            pkt.data[2] = s;
            pkt.length = 4 + 3;
        } else if (argc >= 4 && strcmp(sub, "beacon") == 0) {
            uint16_t sec = (uint16_t)strtoul((const char *)argv[3], NULL, 10);
            uint8_t persist = (argc >= 5) ? (uint8_t)strtoul((const char *)argv[4], NULL, 10) : 0;
            uint8_t target = BROADCAST;
            if (argc >= 6 && strcmp((const char *)argv[5], "all") != 0)
                target = (uint8_t)strtoul((const char *)argv[5], NULL, 10);
            if (sec < 1u || sec > 255u || persist > 1u || target == 0) {
                print("Error: usage: send cfg beacon <sec 1..255> [persist 0|1] [target 1..254|all]\n");
                return;
            }
            pkt.data[0] = 0x10;
            pkt.data[1] = target;
            pkt.data[2] = persist;
            pkt.data[3] = (uint8_t)(sec & 0xFF);
            pkt.data[4] = (uint8_t)(sec >> 8);
            pkt.length = 4 + 5;
        } else {
            print("Usage: send cfg pwr <N> | send cfg sf <N> | send cfg both <pwr> <sf> | send cfg beacon <sec> [persist] [target|all]\n");
            return;
        }

        if (buffer_full(Ulme.pktTxBuf) != GLOB_ERROR_BUFFER_FULL) {
            write_packet(Ulme.pktTxBuf, &pkt);
            print("[CFG] sent, awaiting CMD_ACK...\n");
        } else {
            print("Buffer full\n");
        }
        return;
    }

    /* CFG-OTA relay — remote radio/beacon config with handshake + ack'd
     * transfer + commit + rollback. See cfg_ota_rx_dispatch() in main.c for
     * the receive side and the full wire-format doc.
     *   send cfgota prepare <target>
     *   send cfgota data    <target> <pwr 1..22> <sf 5..12> <beacon_s 1..255>
     *   send cfgota end     <target> <crc32hex>
     */
    if (argc >= 4 && strcmp((const char *)argv[1], "cfgota") == 0) {
        Packet pkt;
        memset(&pkt, 0, sizeof(Packet));
        pkt.pOwner = NET;
        pkt.pktDir = OUTGOING;

        const char *sub = (const char *)argv[2];
        uint8_t target = (uint8_t)strtoul((const char *)argv[3], NULL, 10);

        if (strcmp(sub, "prepare") == 0) {
            pkt.control_app = CFG_OTA_PREPARE;
            pkt.data[0] = target;
            pkt.data[1] = 4;   /* CFG_OTA_PAYLOAD_LEN */
            pkt.length  = APP_HEADER_SIZE + 2;
        } else if (strcmp(sub, "data") == 0 && argc >= 7) {
            uint8_t  pwr = (uint8_t)strtoul((const char *)argv[4], NULL, 10);
            uint8_t  sf  = (uint8_t)strtoul((const char *)argv[5], NULL, 10);
            uint16_t bsec = (uint16_t)strtoul((const char *)argv[6], NULL, 10);
            pkt.control_app = CFG_OTA_DATA;
            pkt.data[0] = target;
            pkt.data[1] = pwr;
            pkt.data[2] = sf;
            pkt.data[3] = (uint8_t)(bsec & 0xFF);
            pkt.data[4] = (uint8_t)(bsec >> 8);
            pkt.length  = APP_HEADER_SIZE + 5;
        } else if (strcmp(sub, "end") == 0 && argc >= 5) {
            uint32_t crc = (uint32_t)strtoul((const char *)argv[4], NULL, 16);
            pkt.control_app = CFG_OTA_END;
            pkt.data[0] = target;
            pkt.data[1] = (uint8_t)(crc & 0xFF);
            pkt.data[2] = (uint8_t)((crc >> 8) & 0xFF);
            pkt.data[3] = (uint8_t)((crc >> 16) & 0xFF);
            pkt.data[4] = (uint8_t)((crc >> 24) & 0xFF);
            pkt.length  = APP_HEADER_SIZE + 5;
        } else {
            print("Usage: send cfgota prepare <target> | data <target> <pwr> <sf> <beacon_s> | end <target> <crc32hex>\n");
            return;
        }

        if (buffer_full(Ulme.pktTxBuf) != GLOB_ERROR_BUFFER_FULL)
            write_packet(Ulme.pktTxBuf, &pkt);
        else
            print("Buffer full\n");
        return;
    }

    /* OTA-over-LoRa relay. The host OTA driver drives this one step at a time;
     * the gateway just builds the single-hop broadcast packet (see the receive
     * side in app_incoming/ota_rx_dispatch). Wire format documented there.
     *   send ota begin <target> <size>
     *   send ota data  <target> <offset> <hexbytes>   (<=40 bytes, 8-aligned)
     *   send ota end   <target> <size> <crc32hex>
     */
    if (argc >= 4 && strcmp((const char *)argv[1], "ota") == 0) {
        Packet pkt;
        memset(&pkt, 0, sizeof(Packet));
        pkt.pOwner = NET;
        pkt.pktDir = OUTGOING;

        const char *sub = (const char *)argv[2];
        uint8_t target = (uint8_t)strtoul((const char *)argv[3], NULL, 10);

        if (strcmp(sub, "prepare") == 0 && argc >= 7) {
            /* send ota prepare <target> <ver16> <size> <crc32hex>
             * Payload: target(1) ver[16] size_lo size_hi crc[4] = 23 bytes */
            const char *ver = (const char *)argv[4];
            uint16_t size = (uint16_t)strtoul((const char *)argv[5], NULL, 10);
            uint32_t crc  = (uint32_t)strtoul((const char *)argv[6], NULL, 16);
            pkt.control_app = OTA_PREPARE;
            pkt.data[0] = target;
            memset(&pkt.data[1], 0, 16);
            size_t vl = strlen(ver);
            if (vl > 16) vl = 16;
            memcpy(&pkt.data[1], ver, vl);
            pkt.data[17] = (uint8_t)(size & 0xFF);
            pkt.data[18] = (uint8_t)(size >> 8);
            pkt.data[19] = (uint8_t)(crc & 0xFF);
            pkt.data[20] = (uint8_t)((crc >> 8) & 0xFF);
            pkt.data[21] = (uint8_t)((crc >> 16) & 0xFF);
            pkt.data[22] = (uint8_t)((crc >> 24) & 0xFF);
            pkt.length   = APP_HEADER_SIZE + 23;
        } else if (strcmp(sub, "begin") == 0 && argc >= 5) {
            uint16_t size = (uint16_t)strtoul((const char *)argv[4], NULL, 10);
            pkt.control_app = OTA_BEGIN;
            pkt.data[0] = target;
            pkt.data[1] = (uint8_t)(size & 0xFF);
            pkt.data[2] = (uint8_t)(size >> 8);
            pkt.length  = APP_HEADER_SIZE + 3;
        } else if (strcmp(sub, "data") == 0 && argc >= 6) {
            uint16_t foff = (uint16_t)strtoul((const char *)argv[4], NULL, 10);
            const char *hex = (const char *)argv[5];
            size_t hl = strlen(hex);
            if ((hl & 1u) || (hl / 2) > 192 || (hl / 2) == 0) {
                print("OTA data: bad hex (1..192 bytes)\n");
                return;
            }
            uint8_t len = (uint8_t)(hl / 2);
            pkt.control_app = OTA_DATA;
            pkt.data[0] = target;
            pkt.data[1] = (uint8_t)(foff & 0xFF);
            pkt.data[2] = (uint8_t)(foff >> 8);
            pkt.data[3] = len;
            for (uint8_t i = 0; i < len; i++) {
                char t[3] = { hex[i * 2], hex[i * 2 + 1], '\0' };
                pkt.data[4 + i] = (uint8_t)strtoul(t, NULL, 16);
            }
            pkt.length = APP_HEADER_SIZE + 4 + len;
        } else if (strcmp(sub, "end") == 0 && argc >= 6) {
            uint16_t size = (uint16_t)strtoul((const char *)argv[4], NULL, 10);
            uint32_t crc  = (uint32_t)strtoul((const char *)argv[5], NULL, 16);
            pkt.control_app = OTA_END;
            pkt.data[0] = target;
            pkt.data[1] = (uint8_t)(size & 0xFF);
            pkt.data[2] = (uint8_t)(size >> 8);
            pkt.data[3] = (uint8_t)(crc & 0xFF);
            pkt.data[4] = (uint8_t)((crc >> 8) & 0xFF);
            pkt.data[5] = (uint8_t)((crc >> 16) & 0xFF);
            pkt.data[6] = (uint8_t)((crc >> 24) & 0xFF);
            pkt.length  = APP_HEADER_SIZE + 7;
        } else {
            print("Usage: send ota prepare|begin|data|end ...\n");
            return;
        }

        if (buffer_full(Ulme.pktTxBuf) != GLOB_ERROR_BUFFER_FULL)
            write_packet(Ulme.pktTxBuf, &pkt);
        else
            print("Buffer full\n");
        return;
    }

    Packet pkt;
    memset(&pkt, 0, sizeof(Packet));
    pkt.pOwner = APP;
    pkt.pktDir = OUTGOING;

    uint8_t *dest = pkt.data;
    uint8_t remaining = sizeof(pkt.data) - 1;

    for (uint16_t i = 1; i < argc && remaining > 0; i++) {
        if (i > 1 && remaining > 0) { *dest++ = ' '; remaining--; }
        uint8_t *src = argv[i];
        while (*src && remaining > 0) { *dest++ = *src++; remaining--; }
    }
    pkt.length = dest - pkt.data;

    if (buffer_full(Ulme.pktTxBuf) != GLOB_ERROR_BUFFER_FULL)
        write_packet(Ulme.pktTxBuf, &pkt);
    else
        print("Buffer full\n");
}

static void ping_commands(void) {
    Packet pkt;
    memset(&pkt, 0, sizeof(Packet));
    pkt.pOwner = NET;
    pkt.pktDir = OUTGOING;
    pkt.control_app = PING;
    pkt.length = 4;

    if (buffer_full(Ulme.pktTxBuf) != GLOB_ERROR_BUFFER_FULL)
        write_packet(Ulme.pktTxBuf, &pkt);
    else
        print("Buffer full\n");
}

void print_routing_table(void) {
    char buf[128];
    RoutingEntry *rt = get_routing_table();
    uint8_t n = get_routing_entries();

    snprintf(buf, sizeof(buf), "Routing table (%u entries):\n", n);
    print(buf);
    for (uint8_t i = 0; i < n; i++) {
        snprintf(buf, sizeof(buf), "  [%u] dest=%u next=%u hops=%u age=%u\n",
                 i, rt[i].destination, rt[i].next_hop, rt[i].hop_count, rt[i].age);
        print(buf);
    }
}

static void set_frequency(uint32_t freq)   { radio_set_channel(freq); print("Done\n"); }
static void set_data_rate(uint8_t dr)      { radio_set_datarate(dr); print("Done\n"); }
static void set_tx_power(uint8_t pw)       { radio_set_tx_power(pw); print("Done\n"); }
static void set_macAddr(uint8_t addr) {
    if (set_mac_address(addr)) print("Error\n"); else print("Done\n");
}
static void softwareReset(void) {
    SCB_AIRCR = 0x05FA0004;  /* SYSRESETREQ */
    while (1);
}

#include "usb_cdc.h"

#define SYSTEM_MEMORY_ADDR  0x1FFF0000

static void jump_to_bootloader(void) {
    typedef void (*pFunction)(void);

    print("Entering DFU bootloader...\n");

    /* Give USB time to send the response */
    for (volatile int i = 0; i < 200000; i++);

    /* Disable USB pull-up so host sees disconnect */
    USB_BCDR &= ~USB_BCDR_DPPU;
    USB_CNTR = 0x0003;  /* FRES + PDWN — power down USB */

    /* Disable SysTick */
    SYST_CSR = 0;

    /* Disable all NVIC interrupts */
    NVIC_ICER = 0xFFFFFFFF;

    /* Clear any pending interrupts */
    NVIC_ISPR = 0;       /* write has no effect on pending; use ICPR */
    (*(volatile uint32_t *)0xE000E280) = 0xFFFFFFFF;  /* NVIC_ICPR */

    /* Enable SYSCFG clock and remap system memory to 0x00000000 */
    RCC_APBENR2 |= (1 << 0);  /* SYSCFGEN */
    SYSCFG_CFGR1 = (SYSCFG_CFGR1 & ~0x3) | 0x1;  /* MEM_MODE = 01 (system memory) */

    __asm volatile ("dsb");
    __asm volatile ("isb");

    /* Read reset vector from system memory */
    uint32_t bootloader_sp   = *(volatile uint32_t *)(SYSTEM_MEMORY_ADDR + 0);
    uint32_t bootloader_addr = *(volatile uint32_t *)(SYSTEM_MEMORY_ADDR + 4);

    /* Set main stack pointer and jump */
    __asm volatile ("msr msp, %0" :: "r" (bootloader_sp));
    ((pFunction)bootloader_addr)();

    while (1);
}
