apku04/stm32_saturn/firmware/src/driver/i2c.c

/*
 * i2c.c — I2C1 & I2C2 master driver for STM32U073
 *
 * I2C1: PB8 = SCL (AF4), PB9 = SDA (AF4)
 * I2C2: PB8 = SCL (AF6), PB9 = SDA (AF6) — INA219
 * Clock: HSI16 (16 MHz), 100 kHz standard mode
 */

#include "i2c.h"
#include "stm32u0.h"
#include "hw_pins.h"

/* Timing for 100 kHz @ 16 MHz HSI:
 * PRESC=3 (4 MHz prescaled), SCLDEL=4, SDADEL=2, SCLH=0x0F, SCLL=0x13 */
#define I2C_TIMING  0x30420F13U

#define I2C_TIMEOUT 100000

/* Base-address register accessors (works for any I2Cx) */
#define IC_CR1(b)     (*(volatile uint32_t *)((b) + 0x00))
#define IC_CR2(b)     (*(volatile uint32_t *)((b) + 0x04))
#define IC_TIMINGR(b) (*(volatile uint32_t *)((b) + 0x10))
#define IC_ISR(b)     (*(volatile uint32_t *)((b) + 0x18))
#define IC_ICR(b)     (*(volatile uint32_t *)((b) + 0x1C))
#define IC_RXDR(b)    (*(volatile uint32_t *)((b) + 0x24))
#define IC_TXDR(b)    (*(volatile uint32_t *)((b) + 0x28))

/* ---- Internal: base-address parameterized I2C operations ---- */

static int i2c_write_impl(uint32_t base, uint8_t addr, const uint8_t *data, uint8_t len)
{
    uint32_t timeout = I2C_TIMEOUT;
    while ((IC_ISR(base) & I2C_ISR_BUSY) && --timeout);
    if (!timeout) return -1;

    IC_CR2(base) = ((uint32_t)addr << 1)
                 | ((uint32_t)len << 16)
                 | I2C_CR2_AUTOEND
                 | I2C_CR2_START;

    for (uint8_t i = 0; i < len; i++) {
        timeout = I2C_TIMEOUT;
        while (!(IC_ISR(base) & I2C_ISR_TXIS) && --timeout) {
            if (IC_ISR(base) & I2C_ISR_NACKF) {
                IC_ICR(base) = I2C_ICR_NACKCF;
                return -2;
            }
        }
        if (!timeout) return -1;
        IC_TXDR(base) = data[i];
    }

    timeout = I2C_TIMEOUT;
    while (!(IC_ISR(base) & I2C_ISR_STOPF) && --timeout);
    IC_ICR(base) = I2C_ICR_STOPCF;

    return 0;
}

static int i2c_read_impl(uint32_t base, uint8_t addr, uint8_t *data, uint8_t len)
{
    uint32_t timeout = I2C_TIMEOUT;
    while ((IC_ISR(base) & I2C_ISR_BUSY) && --timeout);
    if (!timeout) return -1;

    IC_CR2(base) = ((uint32_t)addr << 1)
                 | ((uint32_t)len << 16)
                 | I2C_CR2_RD_WRN
                 | I2C_CR2_AUTOEND
                 | I2C_CR2_START;

    for (uint8_t i = 0; i < len; i++) {
        timeout = I2C_TIMEOUT;
        while (!(IC_ISR(base) & I2C_ISR_RXNE) && --timeout) {
            if (IC_ISR(base) & I2C_ISR_NACKF) {
                IC_ICR(base) = I2C_ICR_NACKCF;
                return -2;
            }
        }
        if (!timeout) return -1;
        data[i] = (uint8_t)IC_RXDR(base);
    }

    timeout = I2C_TIMEOUT;
    while (!(IC_ISR(base) & I2C_ISR_STOPF) && --timeout);
    IC_ICR(base) = I2C_ICR_STOPCF;

    return 0;
}

static int i2c_write_reg_impl(uint32_t base, uint8_t addr, uint8_t reg, uint16_t val)
{
    uint8_t buf[3];
    buf[0] = reg;
    buf[1] = (uint8_t)(val >> 8);    /* MSB first (INA219 is big-endian) */
    buf[2] = (uint8_t)(val & 0xFF);
    return i2c_write_impl(base, addr, buf, 3);
}

static int i2c_read_reg_impl(uint32_t base, uint8_t addr, uint8_t reg, uint16_t *val)
{
    /* Write register pointer (no AUTOEND — use restart) */
    uint32_t timeout = I2C_TIMEOUT;
    while ((IC_ISR(base) & I2C_ISR_BUSY) && --timeout);
    if (!timeout) return -1;

    /* Write phase: 1 byte (register address), no AUTOEND */
    IC_CR2(base) = ((uint32_t)addr << 1)
                 | (1U << 16)      /* NBYTES = 1 */
                 | I2C_CR2_START;

    timeout = I2C_TIMEOUT;
    while (!(IC_ISR(base) & I2C_ISR_TXIS) && --timeout) {
        if (IC_ISR(base) & I2C_ISR_NACKF) {
            IC_ICR(base) = I2C_ICR_NACKCF;
            return -2;
        }
    }
    if (!timeout) return -1;
    IC_TXDR(base) = reg;

    /* Wait for transfer complete (TC, not STOPF since no AUTOEND) */
    timeout = I2C_TIMEOUT;
    while (!(IC_ISR(base) & I2C_ISR_TC) && --timeout);
    if (!timeout) return -1;

    /* Read phase: 2 bytes with AUTOEND */
    IC_CR2(base) = ((uint32_t)addr << 1)
                 | (2U << 16)
                 | I2C_CR2_RD_WRN
                 | I2C_CR2_AUTOEND
                 | I2C_CR2_START;

    uint8_t buf[2];
    for (int i = 0; i < 2; i++) {
        timeout = I2C_TIMEOUT;
        while (!(IC_ISR(base) & I2C_ISR_RXNE) && --timeout);
        if (!timeout) return -1;
        buf[i] = (uint8_t)IC_RXDR(base);
    }

    timeout = I2C_TIMEOUT;
    while (!(IC_ISR(base) & I2C_ISR_STOPF) && --timeout);
    IC_ICR(base) = I2C_ICR_STOPCF;

    *val = ((uint16_t)buf[0] << 8) | buf[1];  /* big-endian */
    return 0;
}

/* ---- Bus-stuck recovery (9-clock unstick) ----
 * If a slave was mid-transaction at the moment of an MCU reset, SDA can be
 * held low forever \u2014 the I2C peripheral will then sit in BUSY and every
 * transfer times out, even after re-init. The standard recovery is to drive
 * SCL manually for up to 9 clocks until the slave releases SDA, then send a
 * STOP condition. Pins are PB8=SCL, PB9=SDA. Called BEFORE switching them to
 * AF mode. */
static void i2c_bus_unstick(void)
{
    /* Configure PB8/PB9 as open-drain GPIO outputs with pull-ups, idle high */
    RCC_IOPENR |= (1 << 1);

    uint32_t m = GPIO_MODER(GPIOB_BASE);
    m &= ~((3 << (INA_SCL_PIN * 2)) | (3 << (INA_SDA_PIN * 2)));
    m |=  ((1 << (INA_SCL_PIN * 2)) | (1 << (INA_SDA_PIN * 2)));  /* output */
    GPIO_MODER(GPIOB_BASE) = m;

    GPIO_OTYPER(GPIOB_BASE) |= (1 << INA_SCL_PIN) | (1 << INA_SDA_PIN);

    uint32_t p = GPIO_PUPDR(GPIOB_BASE);
    p &= ~((3 << (INA_SCL_PIN * 2)) | (3 << (INA_SDA_PIN * 2)));
    p |=  ((1 << (INA_SCL_PIN * 2)) | (1 << (INA_SDA_PIN * 2)));  /* pull-up */
    GPIO_PUPDR(GPIOB_BASE) = p;

    /* Release both lines */
    GPIO_BSRR(GPIOB_BASE) = (1 << INA_SCL_PIN) | (1 << INA_SDA_PIN);
    for (volatile int i = 0; i < 1000; i++) __asm__("nop");

    /* If SDA is held low, clock SCL up to 9 times until it releases */
    for (int i = 0; i < 9; i++) {
        if (GPIO_IDR(GPIOB_BASE) & (1 << INA_SDA_PIN)) break;
        /* SCL low */
        GPIO_BSRR(GPIOB_BASE) = (1 << (INA_SCL_PIN + 16));
        for (volatile int d = 0; d < 200; d++) __asm__("nop");
        /* SCL high */
        GPIO_BSRR(GPIOB_BASE) = (1 << INA_SCL_PIN);
        for (volatile int d = 0; d < 200; d++) __asm__("nop");
    }

    /* Generate STOP: SDA low while SCL high, then SDA high */
    GPIO_BSRR(GPIOB_BASE) = (1 << (INA_SDA_PIN + 16));
    for (volatile int d = 0; d < 200; d++) __asm__("nop");
    GPIO_BSRR(GPIOB_BASE) = (1 << INA_SDA_PIN);
    for (volatile int d = 0; d < 200; d++) __asm__("nop");
}

/* ---- I2C1 public API (PB8/PB9, AF4) ---- */

void i2c_init(void)
{
    /* Enable GPIOB clock */
    RCC_IOPENR |= (1 << 1);

    /* Bus-stuck recovery before switching pins to peripheral AF */
    i2c_bus_unstick();

    /* Enable I2C1 clock (bit 21 of APBENR1) */
    RCC_APBENR1 |= (1 << 21);
    for (volatile int i = 0; i < 10; i++) __asm__("nop");

    /* Configure PB8, PB9 as AF4 open-drain */
    uint32_t m = GPIO_MODER(GPIOB_BASE);
    m &= ~((3 << (INA_SCL_PIN * 2)) | (3 << (INA_SDA_PIN * 2)));
    m |=  ((2 << (INA_SCL_PIN * 2)) | (2 << (INA_SDA_PIN * 2)));  /* AF mode */
    GPIO_MODER(GPIOB_BASE) = m;

    /* Open-drain */
    GPIO_OTYPER(GPIOB_BASE) |= (1 << INA_SCL_PIN) | (1 << INA_SDA_PIN);

    /* Pull-ups (external pullups recommended, but enable internal as fallback) */
    uint32_t p = GPIO_PUPDR(GPIOB_BASE);
    p &= ~((3 << (INA_SCL_PIN * 2)) | (3 << (INA_SDA_PIN * 2)));
    p |=  ((1 << (INA_SCL_PIN * 2)) | (1 << (INA_SDA_PIN * 2)));  /* pull-up */
    GPIO_PUPDR(GPIOB_BASE) = p;

    /* AF4 for PB8, PB9 (AFRH register, pins 8-15) */
    uint32_t afrh = GPIO_AFRH(GPIOB_BASE);
    afrh &= ~((0xF << ((INA_SCL_PIN - 8) * 4)) | (0xF << ((INA_SDA_PIN - 8) * 4)));
    afrh |=  ((4 << ((INA_SCL_PIN - 8) * 4)) | (4 << ((INA_SDA_PIN - 8) * 4)));
    GPIO_AFRH(GPIOB_BASE) = afrh;

    /* Disable I2C before configuration */
    IC_CR1(I2C1_BASE) = 0;

    /* Set timing */
    IC_TIMINGR(I2C1_BASE) = I2C_TIMING;

    /* Enable I2C */
    IC_CR1(I2C1_BASE) = 1;  /* PE = 1 */
}

int i2c_write(uint8_t addr, const uint8_t *data, uint8_t len)
{ return i2c_write_impl(I2C1_BASE, addr, data, len); }

int i2c_read(uint8_t addr, uint8_t *data, uint8_t len)
{ return i2c_read_impl(I2C1_BASE, addr, data, len); }

int i2c_write_reg(uint8_t addr, uint8_t reg, uint16_t val)
{ return i2c_write_reg_impl(I2C1_BASE, addr, reg, val); }

int i2c_read_reg(uint8_t addr, uint8_t reg, uint16_t *val)
{ return i2c_read_reg_impl(I2C1_BASE, addr, reg, val); }

/* ---- I2C2 public API (PB8=SCL, PB9=SDA, AF4 → I2C1 peripheral) ---- */

void i2c2_init(void)
{
    /* Enable GPIOB clock */
    RCC_IOPENR |= (1 << 1);

    /* Bus-stuck recovery before switching pins to peripheral AF \u2014
     * critical after IWDG reset where the INA219 may have been mid-byte. */
    i2c_bus_unstick();

    /* Enable I2C1 clock (bit 21 of APBENR1) — PB8/PB9 AF4 routes to I2C1 */
    RCC_APBENR1 |= (1 << 21);
    for (volatile int i = 0; i < 10; i++) __asm__("nop");

    /* Configure PB8, PB9 as AF mode, open-drain */
    uint32_t m = GPIO_MODER(GPIOB_BASE);
    m &= ~((3 << (INA_SCL_PIN * 2)) | (3 << (INA_SDA_PIN * 2)));
    m |=  ((2 << (INA_SCL_PIN * 2)) | (2 << (INA_SDA_PIN * 2)));
    GPIO_MODER(GPIOB_BASE) = m;

    /* Open-drain */
    GPIO_OTYPER(GPIOB_BASE) |= (1 << INA_SCL_PIN) | (1 << INA_SDA_PIN);

    /* Pull-ups */
    uint32_t p = GPIO_PUPDR(GPIOB_BASE);
    p &= ~((3 << (INA_SCL_PIN * 2)) | (3 << (INA_SDA_PIN * 2)));
    p |=  ((1 << (INA_SCL_PIN * 2)) | (1 << (INA_SDA_PIN * 2)));
    GPIO_PUPDR(GPIOB_BASE) = p;

    /* AF4 for PB8, PB9 (AFRH register, pins 8-15) */
    uint32_t afrh = GPIO_AFRH(GPIOB_BASE);
    afrh &= ~((0xF << ((INA_SCL_PIN - 8) * 4)) | (0xF << ((INA_SDA_PIN - 8) * 4)));
    afrh |=  ((4 << ((INA_SCL_PIN - 8) * 4)) | (4 << ((INA_SDA_PIN - 8) * 4)));
    GPIO_AFRH(GPIOB_BASE) = afrh;

    /* Disable I2C1 before configuration */
    IC_CR1(I2C1_BASE) = 0;

    /* Set timing */
    IC_TIMINGR(I2C1_BASE) = I2C_TIMING;

    /* Enable I2C1 */
    IC_CR1(I2C1_BASE) = 1;
}

int i2c2_write(uint8_t addr, const uint8_t *data, uint8_t len)
{ return i2c_write_impl(I2C1_BASE, addr, data, len); }

int i2c2_read(uint8_t addr, uint8_t *data, uint8_t len)
{ return i2c_read_impl(I2C1_BASE, addr, data, len); }

int i2c2_write_reg(uint8_t addr, uint8_t reg, uint16_t val)
{ return i2c_write_reg_impl(I2C1_BASE, addr, reg, val); }

int i2c2_read_reg(uint8_t addr, uint8_t reg, uint16_t *val)
{ return i2c_read_reg_impl(I2C1_BASE, addr, reg, val); }
