apku04/stm32_saturn/firmware/src/system/hal.c

/*
 * hal.c — Hardware abstraction layer
 * Bridges radio/USB to the protocol stack
 */

#include <stddef.h>
#include <string.h>
#include "hal.h"
#include "usb_cdc.h"
#include "timer.h"

void recieveMode(void) {
    radio_start_rx();
}

GLOB_RET transmitFrame(Packet *pkt) {
    uint8_t payload[PACKET_HEADER_SIZE + DATA_LEN];
    uint8_t tx_len = pkt->length;
    if (tx_len > sizeof(payload)) tx_len = sizeof(payload);
    memcpy(payload, (uint8_t *)pkt + offsetof(Packet, destination_adr), tx_len);

    GLOB_RET errorCode = radio_send(payload, tx_len);

    if (0 == errorCode) {
        if (pkt->control_app == PAYLOAD && pkt->pktDir != RETX) {
            print("Done\n");
            delay_ms(100);
        }
        errorCode = GLOB_SUCCESS;
    }
    return errorCode;
}

bool print(void *data) {
    return cdc_print_str((const char *)data);
}
