apku04/stm32_saturn/firmware/app/lora/test/test_target_test.py

import pytest
import time
import logging
import re
import zlib

from conftest import send_command, STM32_VID, STM32_PID
from header_handler import Header


def _read_until_idle(ser, timeout=3):
    """Read from serial until no new data arrives for 0.5s."""
    data = b''
    deadline = time.time() + timeout
    last_rx = time.time()
    while time.time() < deadline:
        if ser.in_waiting > 0:
            chunk = ser.read(ser.in_waiting)
            data += chunk
            last_rx = time.time()
        elif data and (time.time() - last_rx) > 0.5:
            break
        time.sleep(0.05)
    result = data.decode(errors='ignore')
    # Filter out asynchronous radio RX notifications
    result = re.sub(r'\[RX\][^\n]*\n?', '', result)
    result = re.sub(r'[\x00-\x08\x0e-\x1f]', '', result)
    return result


def wait_for_data(ser, timeout=10):
    """Wait for data to be available and fully received"""
    start_time = time.time()
    while time.time() - start_time < timeout:
        if ser.in_waiting > 0:
            time.sleep(0.5)
            prev_count = ser.in_waiting
            time.sleep(0.2)
            if ser.in_waiting == prev_count:
                return
        time.sleep(0.05)
    else:
        raise Exception("wait_for_data Timeout")


RX_PATTERN = re.compile(
    r"\[RX\]\s+src=(\d+)\s+dst=(\d+)\s+rssi=(-?\d+)\s+prssi=(-?\d+)\s+"
    r"(?:snr=(-?\d+)\s+sf=(\d+)\s+freq=(\d+)\s+)?"
    r"type=(\d+)\s+seq=(\d+)\s+len=(\d+)"
)


def parse_response(response):
    """Parse STM32 [RX] output into header and message parts.

    Firmware format (two lines):
        [RX] src=1 dst=2 rssi=-80 prssi=-80 type=0 seq=42 len=18
        48 65 6C 6C 6F 2C 20 77 6F 72 6C 64 21
    """
    m = RX_PATTERN.search(response)
    if m:
        src = int(m.group(1))
        dst = int(m.group(2))
        rssi = int(m.group(3))
        prssi = int(m.group(4))
        msg_type = int(m.group(8))
        seq = int(m.group(9))
        length = int(m.group(10))
        header = Header(
            rssi=rssi, prssi=prssi, rxCnt=0,
            destination_adr=dst, source_adr=src,
            sequence_num=seq, control_mac=0, protocol_Ver=0,
            TTL=0, mesh_dest=0, mesh_tbl_entries=0,
            mesh_src=0, control_app=msg_type, length=length,
        )
        # Payload hex is on the line(s) after the [RX] line
        after_rx = response[m.end():].strip()
        hex_line = after_rx.split('\n')[0] if after_rx else ""
        hex_bytes = re.findall(r'[0-9A-Fa-f]{2}', hex_line)
        if hex_bytes:
            response_message = bytes(int(b, 16) for b in hex_bytes).decode('ascii', errors='ignore')
            response_message = response_message.replace('\x00', '').strip()
        else:
            response_message = ""
        return header, response_message
    return None, response


def send_and_receive(ser_tx, ser_rx, message, attempts=3):
    """Send a payload and return the parsed RX header/message, retrying RF misses."""
    last_response = ""
    for attempt in range(1, attempts + 1):
        ser_rx.reset_input_buffer()
        send_command(ser_tx, f"send {message}")
        try:
            wait_for_data(ser_rx, timeout=12)
        except Exception:
            logging.warning("No RF data on attempt %d/%d", attempt, attempts)
            time.sleep(1)
            continue

        last_response = ser_rx.read(ser_rx.in_waiting).decode(errors='ignore')
        header, response_message = parse_response(last_response)
        if header and response_message == message:
            return header, response_message
        logging.warning("Unexpected RF response on attempt %d/%d: %r", attempt, attempts, last_response)
        time.sleep(1)

    header, response_message = parse_response(last_response)
    return header, response_message


# ===========================================================================
#  Single-device tests (only need 1 STM32 board)
# ===========================================================================

class TestDeviceSunshineScenarios:
    """Basic command tests — sunshine scenarios"""

    def test_help(self, serial_port):
        serial_port.reset_input_buffer()
        serial_port.write(b'help\r\n')
        response = _read_until_idle(serial_port, timeout=3)
        assert "Commands:" in response
        assert "help" in response
        assert "get" in response
        assert "set" in response
        assert "send" in response
        assert "version" in response

    def test_version(self, serial_port):
        response = send_command(serial_port, 'version')
        assert "STM32_LORA_V1" in response

    def test_get_frequency(self, serial_port):
        response = send_command(serial_port, 'get frequency')
        assert "Frequency:" in response
        assert "Hz" in response

    def test_set_frequency_868(self, serial_port):
        send_command(serial_port, 'set frequency 868000000')
        response = send_command(serial_port, 'get frequency')
        assert "868000000" in response

    def test_get_data_rate(self, serial_port):
        response = send_command(serial_port, 'get data_rate')
        assert "Data Rate:" in response

    def test_set_data_rate(self, serial_port):
        send_command(serial_port, 'set data_rate 7')
        response = send_command(serial_port, 'get data_rate')
        assert "7" in response

    def test_get_tx_power(self, serial_port):
        response = send_command(serial_port, 'get tx_power')
        assert "TX Power:" in response

    def test_set_tx_power(self, serial_port):
        send_command(serial_port, 'set tx_power 14')
        response = send_command(serial_port, 'get tx_power')
        assert "14" in response

    def test_get_mac_address(self, serial_port):
        response = send_command(serial_port, 'get mac_address')
        assert "MAC Address:" in response

    def test_set_mac_address(self, serial_port):
        send_command(serial_port, 'set mac_address 42')
        response = send_command(serial_port, 'get mac_address')
        assert "42" in response

    def test_send_message(self, serial_port):
        response = send_command(serial_port, 'send Hello, world!')
        # send queues the packet; should not error
        assert "Error" not in response

    def test_ping_executes(self, serial_port):
        serial_port.reset_input_buffer()
        serial_port.write(b'ping\r\n')
        time.sleep(0.5)
        response = serial_port.read(serial_port.in_waiting).decode(errors='ignore')
        assert "Error" not in response


class TestDeviceRainyDayScenarios:
    """Error handling tests — rainy day scenarios"""

    def test_invalid_command(self, serial_port):
        with pytest.raises(Exception, match="Send command returned Error"):
            send_command(serial_port, 'invalid_command')

    def test_set_invalid_frequency(self, serial_port):
        with pytest.raises(Exception, match="Send command returned Error"):
            send_command(serial_port, 'set frequency 999999999')

    def test_set_out_of_range_frequency_445mhz(self, serial_port):
        with pytest.raises(Exception, match="Send command returned Error"):
            send_command(serial_port, 'set frequency 445000000')

    def test_set_out_of_range_frequency_920mhz(self, serial_port):
        with pytest.raises(Exception, match="Send command returned Error"):
            send_command(serial_port, 'set frequency 920000000')

    def test_set_invalid_data_rate(self, serial_port):
        with pytest.raises(Exception, match="Send command returned Error"):
            send_command(serial_port, 'set data_rate invalid')

    def test_set_out_of_range_data_rate_13(self, serial_port):
        with pytest.raises(Exception, match="Send command returned Error"):
            send_command(serial_port, 'set data_rate 13')

    def test_set_out_of_range_data_rate_0(self, serial_port):
        with pytest.raises(Exception, match="Send command returned Error"):
            send_command(serial_port, 'set data_rate 0')

    def test_set_invalid_tx_power(self, serial_port):
        with pytest.raises(Exception, match="Send command returned Error"):
            send_command(serial_port, 'set tx_power invalid')

    def test_set_out_of_range_tx_power_0(self, serial_port):
        with pytest.raises(Exception, match="Send command returned Error"):
            send_command(serial_port, 'set tx_power 0')

    def test_set_out_of_range_tx_power_23(self, serial_port):
        with pytest.raises(Exception, match="Send command returned Error"):
            send_command(serial_port, 'set tx_power 23')


class TestMACAddressEdgeCases:
    """MAC address boundary tests"""

    def test_set_mac_address_min_valid(self, serial_port):
        send_command(serial_port, 'set mac_address 1')
        response = send_command(serial_port, 'get mac_address')
        assert "MAC Address: 1" in response

    def test_set_mac_address_max_valid(self, serial_port):
        send_command(serial_port, 'set mac_address 254')
        response = send_command(serial_port, 'get mac_address')
        assert "MAC Address: 254" in response


class TestFlashStorage:
    """Flash configuration storage tests"""

    def test_get_flash_data(self, serial_port):
        time.sleep(0.5)  # Let any pending USB data settle
        serial_port.reset_input_buffer()
        serial_port.write(b'get flash\r\n')
        response = _read_until_idle(serial_port, timeout=5)
        logging.info(f"\nFlash data: {response}")
        assert "Flash Data" in response
        assert "Frequency" in response
        assert "Data Rate" in response
        assert "TX Power" in response
        assert "MAC Address" in response

    def test_write_flash(self, serial_port):
        send_command(serial_port, 'set mac_address 33')
        response = send_command(serial_port, 'set flash 1')
        assert "Done" in response
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
