apku04/stm32_saturn/tools/lora_web/test_gateway_rx.py

"""Tests for gateway_rx, using packets captured from the RAK2243 on 2026-10-15."""

import base64
import json

import gateway_rx as g

# Real rxpk objects logged by lora_pkt_fwd while nodes 10 and 11 were running.
BEACON_RXPK = {"tmst": 8787763, "chan": 0, "rfch": 1, "freq": 868.0, "stat": 1,
               "modu": "LORA", "datr": "SF7BW125", "codr": "4/5", "lsnr": 9.2,
               "rssi": -97, "size": 42,
               "data": "/woRAAAKBwABCgAqCwsBAACgA6ADAQ4HAAAAAAAAAAAAAAAAABgBABHQ"}
PING_RXPK = dict(BEACON_RXPK, lsnr=10.0, rssi=-99, size=12, data="/woAAAAKAAAACgMM")
PONG_RXPK = dict(BEACON_RXPK, lsnr=6.5, rssi=-110, size=12, data="/wsAAAAKAAAACwQM")


class FakeStore:
    def __init__(self):
        self.rows, self.routes, self.console = [], {}, []

    def insert(self, ts, src, rx, beacon):
        self.rows.append((ts, src, rx, beacon))

    def set_node_routes(self, src, routes):
        self.routes[src] = routes

    def console_add(self, text):
        self.console.append(text)


def test_ping_header():
    pkt = g.decode_rxpk(PING_RXPK)
    assert (pkt["dst"], pkt["src"], pkt["type"], pkt["len"]) == (255, 10, g.APP_TYPES.index("PING"), 12)
    assert "beacon" not in pkt


def test_pong_from_node_11():
    pkt = g.decode_rxpk(PONG_RXPK)
    assert pkt["src"] == 11 and pkt["type"] == g.APP_TYPES.index("PONG")
    assert pkt["rx"]["rssi"] == -110 and pkt["rx"]["snr"] == 6


def test_beacon_v7_fields():
    pkt = g.decode_rxpk(BEACON_RXPK)
    assert pkt["src"] == 10 and pkt["seq"] == 17 and pkt["type"] == g.BEACON
    assert pkt["routes"] == [{"dest": 11, "next_hop": 11, "hops": 1}]
    b = pkt["beacon"]
    assert b["entries"] == 1
    assert (b["i_ma"], b["bus_mv"], b["bat_mv"], b["chg"]) == (0, 928, 928, 1)
    assert (b["tx_pwr"], b["sf"]) == (14, 7)
    assert (b["lat_udeg"], b["lon_udeg"], b["fix"]) == (0, 0, 0)
    assert "rst" in b and "up_min" in b
    assert pkt["rx"]["sf"] == 7 and pkt["rx"]["freq"] == 868000000
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
