apku04/stm32_saturn/(commit log)

2026-04-22 Initial commit: STM32U073CBT6 LED blink firmware
    - EasyEDA schematic/PCB project (stm32_lora.eprj)
    - Bare-metal test firmware: alternating LED blink on PB13/PB14
    - Multi-pattern blink firmware (alternate, sync, heartbeat)
    - OpenOCD config for RPi 5 GPIO bitbang SWD
    - Linker script for STM32U073CB (128KB flash, 40KB RAM)
    - Flash and probe helper scripts
    [stm32_lora.eprj]
2026-04-22 Add LoRa mesh firmware port with USB CDC, fix nRST GPIO pin (17->18)
    - Full LoRa mesh stack: SX1262 driver, MAC/network layers, terminal CLI
    - USB CDC virtual COM port for serial interface
    - SPI1 on PA5/PA6/PA7, NSS on PA4
    - Flash config storage on last page (page 63)
    - Fixed openocd.cfg nRST pin from GPIO17 to GPIO18
    - Added end/_end symbols to linker script for sbrk/heap
    - Added hw_pins.h, usb_cdc standalone firmware, schematic files
    [flash_config.c, flash_config.h, globalInclude.h, hal.c, hal.h, hw_pins.h]
2026-04-22 Restructure firmware into modular layout
    Reorganize flat firmware directory into modular structure mirroring PIC24:
    - app/{lora,blink,usb_cdc,test}/ - individual application targets
    - src/driver/ - SPI, SX1262, USB CDC, timer drivers
    - src/protocol/ - MAC layer, network layer
    - src/system/ - packet buffer, terminal, flash config, HAL
    - src/board/ - hardware pin definitions
    - include/ - MCU header, global includes
    - linker/ - linker script
    - tools/ - OpenOCD config, flash/probe scripts
    Add pytest target test suite under app/lora/test/
    Update all Makefiles for new include/source paths
    Update .gitignore with build/, __pycache__/, .pytest_cache/
2026-04-22 Add software DFU bootloader entry via 'dfu' terminal command
    - terminal.c: Add 'dfu' command that disconnects USB, remaps system memory,
    and jumps to STM32 ROM bootloader (0x1FFF0000)
    - stm32u0.h: Add SCB_VTOR, SYSCFG_BASE/CFGR1 register defines
    - tools/dfu_flash.sh: Convenience script for USB DFU flashing
    Usage: tools/dfu_flash.sh app/lora/lora.bin --enter
    No jumper needed — send 'dfu' over USB CDC, device re-enumerates as
    DFU (0483:df11), flash with dfu-util, ':leave' jumps back to app.
    Option byte nBOOT_SEL=0 so BOOT0 pin also works as hardware fallback.
2026-04-22 Add battery voltage measurement via ADC
    - src/driver/adc.c/h: ADC1 driver for PB4 (ADC1_IN22) battery sense
    with 8-sample averaging and sense LDO (PA15) always-on
    - stm32u0.h: ADC1 register definitions
    - terminal.c: 'get battery' command returns mV and raw ADC value
    - main.c: adc_init() in startup, battery mV in beacon packets (2-byte LE)
    - Makefile: add adc.c to build
    - test: test_get_battery verifies response format and formula
    Hardware: 1M/1M divider, BSENSE = VBAT/2, 12-bit ADC, 3.3V ref
    Formula: battery_mV = raw * 6600 / 4096
2026-04-23 Add solar charge telemetry to beacon packet
    - Add I2C1 master driver (PB6/PB7, 100kHz) for INA219 communication
    - Add INA219 driver: read solar input bus voltage (mV)
    - Add charge status GPIO reader (PA10=CHRG, PA8=STDBY, TP4056-style)
    - Extend beacon payload: bat_mv(2B) + solar_mv(2B) + charge_status(1B)
    - Add 'get solar' and 'get charge' terminal commands
    - Add I2C1 register definitions to stm32u0.h
2026-04-23 Add LoRa monitor GUI and improve beacon RX output
    - Print [BEACON] line for all beacon types (full telemetry, legacy, minimal)
    - Print non-beacon payload as hex instead of raw binary
    - Add Python tkinter GUI (tools/lora_monitor.py) with packet table,
    beacon dashboard, raw log, command entry, and quick buttons
    - Auto-detects STM32 (VID 0483) and PIC24 (VID 04D8) devices
    - Cross-platform: Linux, macOS, Windows
2026-04-23 i2c: migrate from I2C1 to I2C2 (PB8/PB9) for INA219
    INA219 is on I2C2 (PB8=SCL, PB9=SDA, AF4), not I2C1 (PB6/PB7)
    which is just a header connector. Changes:
    - Add I2C2 register definitions to stm32u0.h
    - Update i2c.c to use I2C2 peripheral (clock, pins, AFRH)
    - Update terminal i2cscan print string to say I2C2
    - Update comments in i2c.h and ina219.c
2026-04-23 fix: switch INA219 from I2C1 to I2C2, add shunt+battery to beacon
    - I2C2 on PB13/PB14 (AF6): added i2c2_init/read/write/reg functions
    - Refactored i2c.c with base-address macros to avoid duplication
    - INA219 now uses I2C2; added shunt voltage register (0x01) read
    - Beacon payload v2: shunt_mv(2)+bus_mv(2)+bat_mv(2)+chg(1) = 7 bytes
    - RX parser handles both v2 (7-byte) and legacy (5-byte) beacons
    - lora_monitor.py: added BEACON_PATTERN_V2 with shunt/bus/bat columns
    - LEDs (PB13/PB14) disabled in lora app — pins reassigned to I2C2
    [hw_pins.h, i2c.c, i2c.h, ina219.c, ina219.h, lora_monitor.py, main.c]
2026-04-23 fix(i2c2): PB8/PB9 AF6 for I2C2, restore LEDs on PB13/PB14
    Yarrick's commit correctly added I2C2 driver and beacon payload but
    assigned I2C2 to PB13/PB14 (LEDs). PCB ground truth (Kotov) confirms
    INA219 wired to PB8/PB9. STM32U073 supports AF6=I2C2 on PB8/PB9.
    - hw_pins.h: INA_SCL/SDA stay PB8/PB9, LED1/LED2 restored PB13/PB14
    - i2c.c: i2c2_init() now uses PB8/PB9 AFRH=0x66 (AF6 for both pins)
    - main.c: LED functions restored
    Reviewed-by: Eisenhorn
    [hw_pins.h, i2c.c, main.c]
2026-04-23 Scribe: I2C2/INA219 session orchestration & documentation
    - Added orchestration logs for Kotov (PCB findings), Yarrick (I2C2 impl),
    Eisenhorn (review & verdict), Cawl (fix application), Brostin (testing)
    - Consolidated 4 decision inbox files into .squad/decisions.md (deduplicated)
    - Deleted inbox files after merge
    - Updated cross-agent learnings in agent history files:
    * Kotov: PCB validation chain & findings locked
    * Yarrick: Lock-out reasoning & pin verification gap documented
    * Eisenhorn: AF vs pin migration decision documented
    * Cawl: Pin/peripheral locking principles documented
    * Brostin: Testing strategy & baseline findings documented
    - Created session log: I2C2/INA219 beac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
2026-04-23 fix(test): rewrite parse_response() for STM32 [RX] format
    Replace PIC24 pipe-delimited parser with regex matching STM32 output:
    [RX] src=X dst=X rssi=X prssi=X type=X seq=X len=X
    HH HH HH ... (space-separated hex payload)
    Also reset radio config in serial_ports fixture to prevent
    cross-test contamination from earlier single-device tests.
    [test_target_test.py]
2026-04-23 fix(adc): correct PB4 channel 22→13 and add PCLK/2 clock
    Root cause: PB4 on STM32U073 maps to ADC1_IN13 (not IN22).
    Channel 22 does not exist on this MCU, causing the ADC to read
    a floating/nonexistent input (~215 mV garbage).
    Changes:
    - ADC_CHANNEL_BAT: 22 → 13 (empirically verified via pin toggle)
    - CFGR2: set CKMODE=01 (PCLK/2 synchronous) — the default async
    mode (CKMODE=00) requires RCC_CCIPR ADCSEL which was never set
    - Clear VBATEN in ADC_CCR to prevent internal VBAT/3 from
    overriding the external PB4 signal on shared channel 13
    - Add adc_read_channel_raw() and adcscan terminal command for
    future diagnostics
    - Keep 2x divider formula (1M/1M per schematic notes)
    NOTE: on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
    [adc.c, adc.h, terminal.c]
2026-04-23 fix(bat_mv): use INA219 bus voltage as battery proxy
    PB4 has no ADC on STM32U073CBT6 — BAT_SENSE cannot be read via ADC.
    MCU VBAT pin is on 3.3V rail, not battery. No ADC-capable pin is free.
    Workaround: read bat_mv from INA219 bus voltage register (battery-side).
    Stub adc_read_bat_mv() to return 0 with hardware limitation comment.
    [adc.c, main.c]
2026-04-23 docs: consolidate battery ADC investigation, archive decisions inbox
    Scribe session 2026-04-23T16:11:56Z
    Consolidates findings from battery ADC investigation:
    - 7 new decisions merged into decisions.md (Kotov INA219 audit, Yarrick
    ADC rejection, Eisenhorn verification, Cawl INA219 workaround, parser fix,
    VBAT routing analysis, board src address directive)
    - 8 orchestration logs created per agent (kotov-ina219-populated,
    brostin-parser-fix, yarrick-bat-adc, eisenhorn-adc-review,
    kotov-vbat-routing, eisenhorn-cawl-review, cawl-batmv-reroute,
    brostin-flash-test)
    - 1 session log documenting investigation phases and team decisions
    - Decision inbox archived (9 files deleted, merged into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
2026-04-23 fix(i2c): use AF4+I2C1 for PB8/PB9 INA219 (not AF6+I2C2)
    PB8/PB9 with AF4 routes to I2C1 peripheral on STM32U073.
    Previous use of AF6+I2C2 caused ret=-1 timeout on all ops.
    [i2c.c]
2026-04-23 chore: save I2C/INA219 verified findings to squad memory
    - INA219 at 0x40 confirmed on hardware
    - AF4+I2C1_BASE fix documented as ground truth
    - ADC workaround noted in Kotov history
2026-04-23 feat: derive unique node address from STM32 UID
    Both boards were using address 2 (flash default fallback).
    Now XOR-fold the 96-bit UID to a stable unique uint8_t per chip.
    Printed at boot: [BOOT] node_addr=N
2026-04-23 docs(squad): merge inbox decisions, log unique src address from STM32 UID (0x1FFF6E50)
    - Consolidated 5 inbox decision files into decisions.md (entries 10-14)
    - Deduplicated decision records (INA219 pinout, I2C hardware verify, board flash results)
    - Added session log: UID derivation for unique node_addr per board
    - Updated yarrick/history.md: CRITICAL note on STM32U073 UID base (0x1FFF6E50, NOT 0x1FFF7590)
    - Board 2 verified: node_addr=33 confirmed
    - Deleted .squad/decisions/inbox/*.md files
2026-04-23 fix: beacon payload offset mismatch — shunt/bus/bat now decoded correctly
    RX was skipping mesh_tbl_entries*3 bytes before telemetry, but TX
    placed telemetry at data[0] with no table prefix. With entries=1,
    app_off=3 causing reads from wrong bytes → all zeros.
    Two changes in networklayer.c:
    1. network_outgoing: force mesh_tbl_entries=0 for BEACON packets so
    the routing table is not prepended to beacon data (telemetry stays
    at data[0]). PING/PONG still carry the table for mesh discovery.
    2. process_received_beacon: only strip the CRC byte (length -= 1)
    when mesh_tbl_entries > 0, since CRC is only appended when the
    routing table is present.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
2026-04-24 squad: recast members to Warhammer 40K Primarch names
    Rename all 7 cast members to Primarchs of the Adeptus Astartes:
    - Cawl → Guilliman (Architect)
    - Kotov → Ferrus (PCB Expert)
    - Mkoll → Corax (RPi GPIO Expert)
    - Yarrick → Dorn (STM32 Expert)
    - Ravenor → Khan (LoRa Expert)
    - Eisenhorn → Lion (Reviewer)
    - Brostin → Russ (Tester)
    Updates roster, routing, casting registry/history, all charters and
    agent history headers. Agent directories renamed via git mv. Append-only
    historical files (decisions.md, log/, orchestration-log/, test results)
    intentionally preserved with old names.
2026-04-24 squad: extract initial skills (DFU, I2C mux, INA219, beacon v3, serial hygiene)
2026-04-24 squad: extract driver & system skills (sx1262, spi, charger, adc, timer, usb-cdc, flash-config, hal, packetbuffer, terminal)
2026-04-24 firmware: solar telemetry bring-up + beacon payload v3
    - ina219: add ina219_read_shunt_uv() returning signed µV at 10µV LSB
    resolution (old _mv() truncated low currents to zero)
    - terminal: rewrite `get solar` output — bus mV / shunt µV / I mA / P mW
    / charge state, using 50 mΩ shunt R58 (not 100 mΩ as previously assumed)
    - adc: incremental work toward battery sensing (PB4 has no ADC channel
    on STM32U073 — INA219 bus voltage used as battery proxy instead)
    - app/lora/main.c: beacon payload v3 = i_ma(LE int16) + bus_mv + bat_mv
    + chg, source-side mA conversion so receivers don't need shunt value.
    RX decode prints [BEACON] i_ma=... bus=... bat=... chg=... entries=...
    - tools/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
2026-04-24 chore: add squad infra, GitHub workflows, and hardware docs
    - .copilot/: Squad CLI skill library + MCP config (33 files, installed
    by squad tooling — coordinator-side knowledge, separate from the
    project-specific .squad/skills/ extracted this session)
    - .github/agents/squad.agent.md: coordinator governance file
    - .github/workflows/: squad-heartbeat, squad-issue-assign, squad-triage,
    sync-squad-labels — GitHub Actions for issue/PR automation
    - docs/hardware/: schematic exports (PNG/SVG/TXT) and INA219 datasheet
    (was a9936df89be24cd39d8deb7a1072c574.pdf — renamed for clarity)
2026-04-25 firmware: add OTA flash bank driver + terminal commands + pytest suite
    - flash_ota.{c,h}: OTA bank driver for STM32U073 128KB layout
    - Bank: pages 32-62 at 0x08010000 (62KB usable)
    - Config page 63 at 0x0801F800 (shared with flash_config)
    - 8-byte aligned doubleword programming, erase-verify, write-readback
    - Pending flag + 16-bit image size in config page slots
    - globalInclude.h: add OTA_PENDING_FLAG, OTA_IMAGE_SIZE_LO/HI param slots
    - terminal.c: OTA commands (Russ)
    - get ota bank | get ota read <off> <len> | get ota pending
    - set ota erase | set ota write <off> <hex16> | set ota pending <sz> | set ota clear
    - app/lora/Makefile: link flash_ota.c
    - test_target_test.py: TestOTAFl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
2026-04-26 feat(radio): decode SX1262 SignalRssiPkt + SnrPkt; add snr field to Packet
    GET_PKT_STATUS returns 3 bytes per datasheet 13.5.3:
    [0] RssiPkt -> rssi = -RssiPkt/2 dBm (avg over packet)
    [1] SnrPkt (s8) -> snr = SnrPkt/4 dB
    [2] SignalRssiPkt -> prssi = -SignalRssiPkt/2 dBm (LoRa signal only)
    Previously prssi was a copy of rssi (placeholder). Now correctly read from
    SignalRssiPkt. snr is captured in the new int8_t Packet.snr field for use
    by the network layer / UI in subsequent steps.
    Step 1 of incremental SNR/remote-config rollout. Verified: both boards
    continue exchanging beacons after change.
    [globalInclude.h, sx1262.c]
2026-04-26 feat(proto): add CMD_CFG and CMD_ACK to PacketType enum
    Reserve enum values 5 (CMD_CFG) and 6 (CMD_ACK) for the upcoming
    remote-config feature: base station sends CMD_CFG to change tx_power/SF
    on a remote field device, which replies with CMD_ACK.
    Step 2 of incremental rollout. Header-only change. Verified: beacons
    still flow on both boards.
2026-04-26 feat(net): widen signal_strength to int16_t; route CMD_CFG/ACK like PING
    - signal_strength was int8_t but pkt->prssi is int16_t; widen to match
    and avoid implicit narrowing on negative dBm values.
    - Treat CMD_CFG/CMD_ACK as TTL=0 broadcasts in network_outgoing,
    same handling as PING/PONG (no routing-table prepend, single hop).
    Step 3 of incremental rollout. Verified: beacons still flow on both boards.
2026-04-26 feat(terminal): add 'send cfg pwr/sf/both' remote-config commands
    Base operator can now broadcast a CMD_CFG packet to remote devices:
    send cfg pwr <N> -> set tx_power (1..22)
    send cfg sf <N> -> set SF (5..12)
    send cfg both <pwr> <sf> -> set both atomically
    Payload format: data[0]=op (0x01=pwr, 0x02=sf, 0x03=both), then operand bytes.
    Field device's CMD_CFG handler (next step) will validate and reply CMD_ACK.
    Step 4 of incremental rollout. Verified: command queued, beacons unaffected,
    out-of-range values rejected.
2026-04-26 feat(app): extend [RX] log with snr/sf/freq for range testing
    [RX] now reports snr (dB), sf (current data_rate), and freq (Hz) so the
    operator and lora_monitor.py UI can correlate received signal quality
    with the radio config in use. Required for the range-test workflow.
    Step 5a of incremental rollout. Verified: snr=12-13 dB at close range,
    sf=7 freq=868000000 as configured.
2026-04-26 feat(beacon): v4 payload — beacon now carries remote tx_pwr + sf
    Beacon telemetry payload extended from 7 to 9 bytes:
    [0..1] i_ma (signed)
    [2..3] bus_mv
    [4..5] bat_mv
    [6] charge_status
    [7] tx_pwr (NEW)
    [8] sf (NEW)
    Decoder accepts v4 first, falls back to v3/legacy for older nodes.
    Lets the base operator confirm a CMD_CFG actually took effect on the
    remote without needing a CMD_ACK round-trip every time.
    Step 5b of incremental rollout. Verified: both boards report tx_pwr=14
    sf=7 in [BEACON].
2026-04-26 feat(app): CMD_CFG handler + CMD_ACK printer (remote tx_pwr/sf control)
    Field device:
    - On CMD_CFG receive: parse op (0x01=pwr, 0x02=sf, 0x03=both), validate
    range, queue CMD_ACK FIRST, THEN apply via radio_set_tx_power /
    radio_set_datarate (RAM-only — survives reset reverts to flash defaults).
    - ACK is queued before apply so it goes out at the OLD power/SF and is
    guaranteed to reach the base.
    Base device:
    - On CMD_ACK receive: print '[CMD_ACK] from=N op=X status=S tx_pwr=P sf=F'
    for operator confirmation.
    Step 5c (final firmware step) of incremental rollout. Verified end-to-end:
    base> send cfg pwr 10
    field receives CMD_CFG (type=5), prints [CFG] applied
    base receives CMD_A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
    [main.c]
2026-04-26 squad: add Perturabo (The Critic, gpt-5.4); confirm opus-4.6 default
    - New agent: Perturabo — adversarial critic role
    Charter: stress-test architecture, protocol, power/timing assumptions
    Model override: gpt-5.4 (saved to config.json agentModelOverrides)
    - defaultModel confirmed: claude-opus-4.6 (all other agents)
    - Updated team.md, routing.md, casting/registry.json
2026-04-26 feat(gps): fix AF7, LDO power, RXNE ISR, beacon GPS payload
    Fix 1: Drive PA15 (SENSE_LDO_EN) HIGH before USART2 config — GPS
    module was unpowered. 100ms stabilisation delay added.
    Fix 2: PA2/PA3 alternate function AF4 → AF7 (RM0503 Table 20).
    AF4 routes to LPUART2, not USART2. UART was electrically dead.
    Fix 3: gps_poll() now drains from ring buffer — fully non-blocking.
    Fix 4: USART2 RXNE interrupt with 64-byte ring buffer. ISR captures
    bytes and clears ORE. Prevents NMEA corruption during SX1262 blocking
    radio operations. Vector table extended to cover IRQ 28.
    Fix 5: Beacon v5 payload adds lat_udeg(4) + lon_udeg(4) + fix_valid(1)
    at pkt.data[9..17]. Total 18/50 bytes. Sends zeros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
    [gps.c, gps.h, main.c, terminal.c]
2026-04-26 squad: Lion APPROVED GPS fixes — cleared for flash
2026-04-26 squad: log GPS VTOR fix session — Dorn, Lion, Scribe
    Root cause found: VTOR not set post-DFU. All interrupts dead.
    GPS driver fixed and both boards reflashed.
    GPS working: fix=1, sats=9.
2026-04-26 fix(gps): set VTOR + fix USART2 driver bugs
    Root cause of post-DFU GPS failure: VTOR not set after DFU boot.
    DFU bootloader leaves VTOR pointing at system ROM, killing all
    interrupts including USART2_IRQHandler. Fix: SCB_VTOR = 0x08000000u
    as first instruction in Reset_Handler.
    Additional GPS driver fixes:
    - Clear FE/NE flags in USART2_IRQHandler (not just ORE)
    - Restore RXNEIE in gps_set_baud() and gps_set_af()
    - Restore PA3 AF+USART2 at end of gps_probe_pa3()
    - Auto-baud fallback to 4800 in gps_poll() if FE persists
    - Polling fallback drains RDR directly as ISR backup
    - Add 'get gps reinit' terminal command
    - Add get_tick_ms() to timer.c/h
    - Add USART ISR/ICR FE/NE bit macros to stm32u0.h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
    [gps.c, gps.h, main.c, terminal.c, timer.c, timer.h]
2026-04-26 fix(monitor): show stale GPS indicator when node loses fix
    _update_gps_tab() was only called when fix=1, leaving the GPS tab
    showing the last good coordinates indefinitely after fix loss.
    - Always call _update_gps_tab() for v5 beacons regardless of fix
    - fix=0: show greyed '[stale]' coords with '✗ NO FIX' indicator
    - fix=1: show green '✓ FIX' with normal coordinates
    - Replace unused ALT column with LAST FIX timestamp per node
    - Track last_fix_time dict for per-node fix history
    Addresses Perturabo Concern 5.
    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
    [lora_monitor.py]
2026-04-26 fix: 4 firmware concerns from Perturabo audit
    - TX now sends pkt->length bytes instead of fixed sizeof(Packet) (Concern 1)
    - Added GPRMC/GNRMC sentence parsing for GPS fix (Concern 3)
    - Increased USART2 ring buffer from 64 to 256 bytes (Concern 4)
    - Added NMEA checksum verification before parsing (Concern 7)
    [gps.c, hal.c]
2026-04-26 Scribe: Document Perturabo 7-concern resolution
    - Merge 5 inbox decision files → decisions.md (deduplicates, centralizes records)
    - Remove inbox files after merge
    - Create orchestration logs for each agent (Dorn, Ferrus, Corax, Khan, Lion)
    - Create session log summarizing all 7 concerns and their resolution
    - Update agent history files with session completion notes
    - Cross-reference team changes for each affected agent
    Concerns resolved:
    1. TX sends fixed 62 bytes → variable-length via pkt->length
    2. PA15/PA1 mismatch → verified PA15 correct per schematic
    3. Ring buffer 64 bytes → expanded to 256 bytes
    4. Only GGA parsing → added GPRMC/GNRMC support
    5. GPS monitor stale display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
2026-04-27 fix(radio): SF/power changes hang radio; fix UID-based MAC collision
    Firmware:
    - sx1262: radio_set_datarate/tx_power now do standby->set->restart_rx;
    calling set_modulation_params from RX-continuous left the radio in an
    undefined state (SF didn't apply on RX path, chip stalled -> 'super slow').
    - maclayer: replace flat XOR fold with FNV-1a 32-bit over UID; sibling
    dies on the same wafer share 8 of 12 UID bytes which cancel under XOR
    and produce identical MACs. FNV-1a preserves byte-position entropy.
    Distinct seeds for fingerprint vs derived address.
    - stm32u0.h: UID_BASE corrected to 0x1FFF6E50 (0x1FFF7590 reads 0 on U073).
    - globalInclude: add UID_FINGERPRINT enum slot.
    - flash_co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
    [flash_config.c, flash_config.h, globalInclude.h, lora_monitor.py, sx1262.c, terminal.c]
2026-05-03 feat(beacon): add SHT3x/BME280 temp+humidity to beacon (v6) + monitor polish
    - New bit-bang I2C on PB6/PB7 (external header) — bb_i2c.{c,h}
    - BME280/BMP280 driver with chip-id auto-detect — bme280.{c,h}
    - SHT3x driver (single-shot, CRC, 0x44/0x45 auto) — sht3x.{c,h}
    - main.c: init both, prefer SHT3x, fallback BME280, ship temp_cdeg+hum_cpct
    in beacon (payload v6 = 22 bytes, length = 4 + 22)
    - main.c: decode v6 fields in [BEACON] log
    - Makefile: add bb_i2c.c, bme280.c, sht3x.c
    - terminal.c: 'get bbscan' / 'get bme' / 'get sht' diagnostics
    - lora_monitor.py: parse v6 (temp/RH), new Nodes overview tab,
    Beacons CSV export, RSSI link-strength colors, status bar with
    uptime/byte counte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
2026-05-04 Fix LoRa RX bring-up and target tests
    [flash_ota.c, main.c, test_target_test.py]
2026-05-10 feat(diag): persistent boot/reset event log + W25Q32 driver + I2C bus recovery
    Field debugging infrastructure for the MAC44 wedge investigation. Adds a
    persistent event log on the external W25Q32 flash that survives BOR, IWDG,
    and USB/battery hand-over (the failure modes that .noinit RAM cannot).
    - ext_flash.c/h: bit-bang SPI driver for W25Q32 (PB5/10/11/12).
    Page-aware writes, sector/block/chip erase. flash_wait_busy is bounded
    with a timeout and refreshes the IWDG so a long erase cannot trigger a
    watchdog reset. ext_flash_init verifies JEDEC ID 0xEF4016 and exposes
    ext_flash_present() so a missing/dead chip cannot brick boot.
    - event_log.c/h: 128-slot ring buffer in W25Q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
    [bb_i2c.c, bb_i2c.h, event_log.c, event_log.h, ext_flash.c, ext_flash.h, i2c.c, main.c]
2026-05-10 feat(tools): beacon v7 decoding + gateway web UI + interleave fix
    Host-side support for the new firmware diagnostic telemetry.
    lora_monitor.py:
    - BEACON_PATTERN_V7 regex matching the 4 new diag fields
    (rst, boot, last_stage, up_min) appended to v6 beacons.
    - Fix: pre-split CDC stream on [RX]/[BEACON] markers so packets that
    print mid-line (e.g. 'freq=8680000[RX] src=44 ...') still parse.
    - Pending-RX grace period (~5s) so a [BEACON] that lands in a separate
    USB CDC chunk still pairs with its [RX] header instead of being
    flushed as orphan.
    tools/lora_web/ (new):
    - server.py: HTTP/SQLite gateway serving /api/map and /api/beacons,
    parses v6+v7 beacons from a CDC port, applies the sa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
    [lora_monitor.py, server.py]
2026-06-24 feat(ota): wireless LoRa firmware update — full transfer + apply working
    End-to-end OTA over the LoRa mesh: PREPARE/DATA/END/ACK protocol with
    stop-and-wait ARQ, CRC32 image verification, a RAM-resident applier that
    copies the staged bank over the application at boot, and a gateway web UI
    (tools/lora_web) + dev web tool (tools/dev_web) to drive it.
    Validated end-to-end on hardware: a new build transfers over the air
    (1070/1070 chunks, CRC verified), the target self-applies and reboots onto
    the new image, and a re-push is correctly rejected as up_to_date.
    Four bugs found and fixed while bringing the apply path up:
    - maclayer.c: aloha_channel_access had an unbounded CSMA busy-wait with no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
2026-06-24 perf(ota): ~5x faster OTA via 192-byte fragments + no pre-TX delay for OTA
    The OTA was stop-and-wait with 40-byte fragments and an unconditional random
    40-220ms pre-transmit delay on every frame, so a ~42KB image took ~13.5 min.
    - Enlarge the on-air payload: Packet.data[] 50 -> DATA_LEN(200); raise OTA
    fragment to 192 bytes. Propagated the size through every buffer in the path:
    RX guards (sx1262.c), the TX serialization buffer (hal.c payload[]), the
    gateway command-line buffer (terminal MAX_ARGV 128 -> 480, terminal() size
    arg widened to uint16_t, main.c line[] 128 -> 480), and the "bad hex" limit.
    Server OTA_CHUNK 40 -> 192.
    - maclayer.c: skip the random pre-TX back-off delay for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
2026-08-26 feat(dev_web): wire OTA-over-LoRa into the dev dashboard
    Replace the "future work" OTA placeholder with a real driver, ported
    from tools/lora_web/server.py's ota_driver() (PREPARE/DATA/END,
    stop-and-wait ARQ with retries). Reads [OTA_ACK] lines off the
    device's existing ConsoleSession stream instead of opening a second
    serial connection, so it doesn't fight the dashboard's own console
    for the port.
    - server.py: OtaState + ota_driver(), POST /api/ota/start, GET
    /api/ota/status. /api/firmwares now also reports each binary's
    build_id (SATVER tag). Fixed ConsoleSession line-splitting to
    inject newlines before [BTBL]/[OTA_ACK] markers too (previously
    only [RX]/[BEACON]), matching lora_we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
2026-10-15 feat(ota): LoRa configuration OTA (tx power / SF / beacon) with verify + rollback
    Firmware: CFG_OTA_PREPARE/DATA/END/ACK handshake stages new radio params
    as provisional, reboots, pings the last peer to verify the link, and
    rolls back to the backup config if verification fails. Beacons and
    firmware OTA are suspended while a config OTA is active. Adds terminal
    commands and target tests for the flow.
    dev_web: new /config "OTA Config" page, /api/nodes, /api/cfgota/start
    and /api/cfgota/status endpoints driving the config OTA from the
    dashboard; nav links added to the existing pages.
2026-10-16 feat(lora_web): Enclosure tab — SHT3x case temp/humidity + Pi CPU logging
    Gateway Pi now samples an SHT3x inside the outdoor case (I2C-1, 0x44)
    every 60 s alongside the Pi SoC temperature, stored in env_readings in
    beacons.db. New Enclosure tab shows case air / CPU / dew point, peaks,
    condensation margin, throttle state and threshold alerts, with CSV
    export via /api/env.csv. Page title renamed to "Gateway".
